julessouren/kicad-library-sa/SA_3dshapes/Knobs/vol control/Assem1.SLDASM

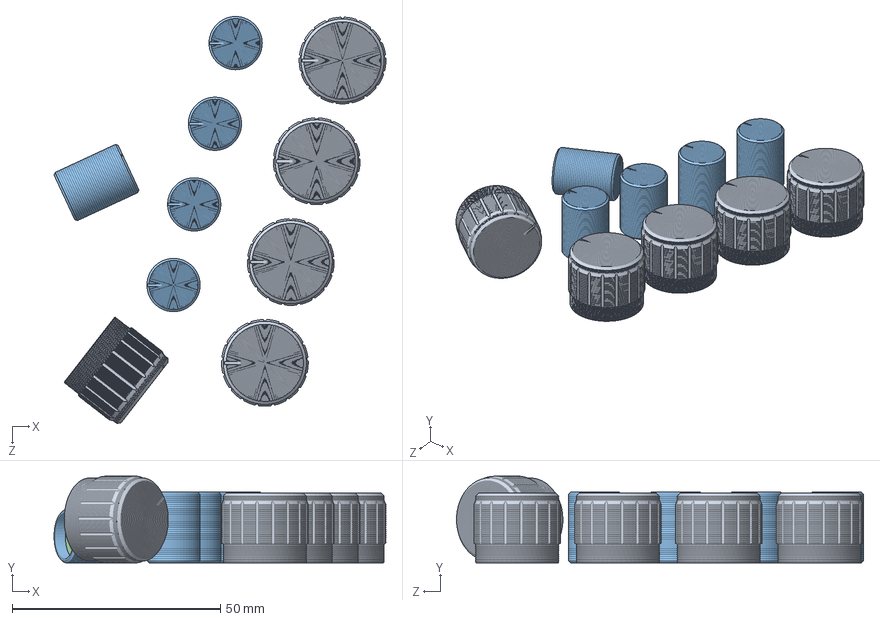
[picture p1: CAD file, 2019-04-16]
SA_3dshapes/Knobs/vol control/Assem1.SLDASM
79.7 x 20.8 x 97.8 mm
宽 20 out x 5
宽 20 inner x 5
12.8 旋钮 x 5
12.8 INNER x 5
