julessouren/kicad-library-sa/SA_3dshapes/Knobs/vol control/宽 20 旋钮.SLDASM

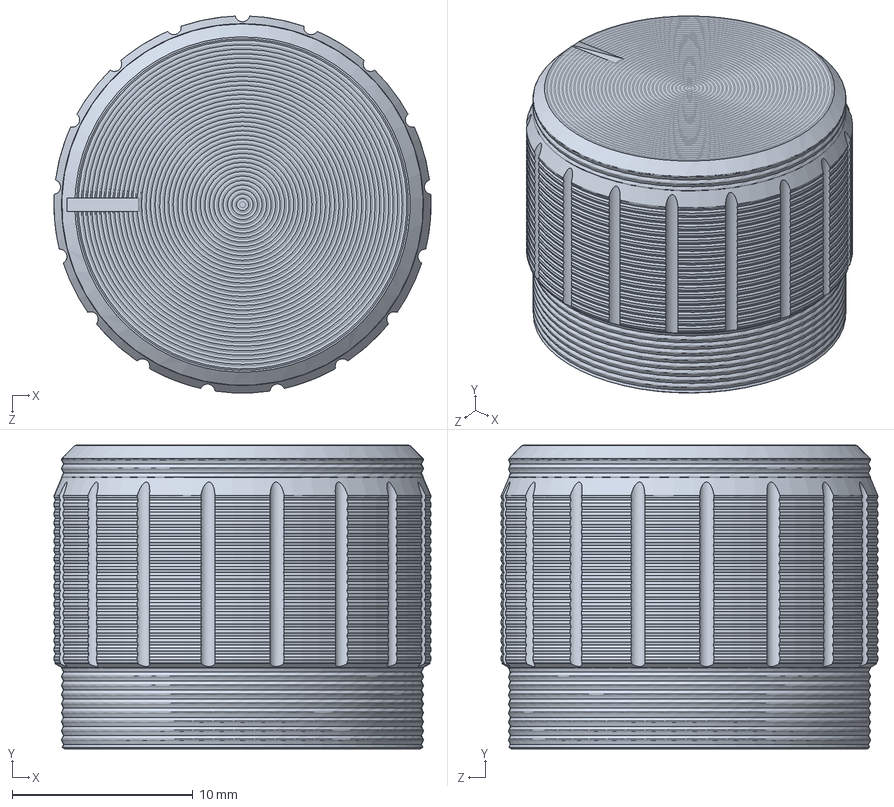
[picture p2: CAD file, 2019-04-16]
SA_3dshapes/Knobs/vol control/宽 20 旋钮.SLDASM
20.8 x 16.8 x 20.8 mm
宽 20 out
宽 20 inner
