julessouren/kicad-library-sa/SA_3dshapes/Packages/InputJack_Cover_Assembly.stp

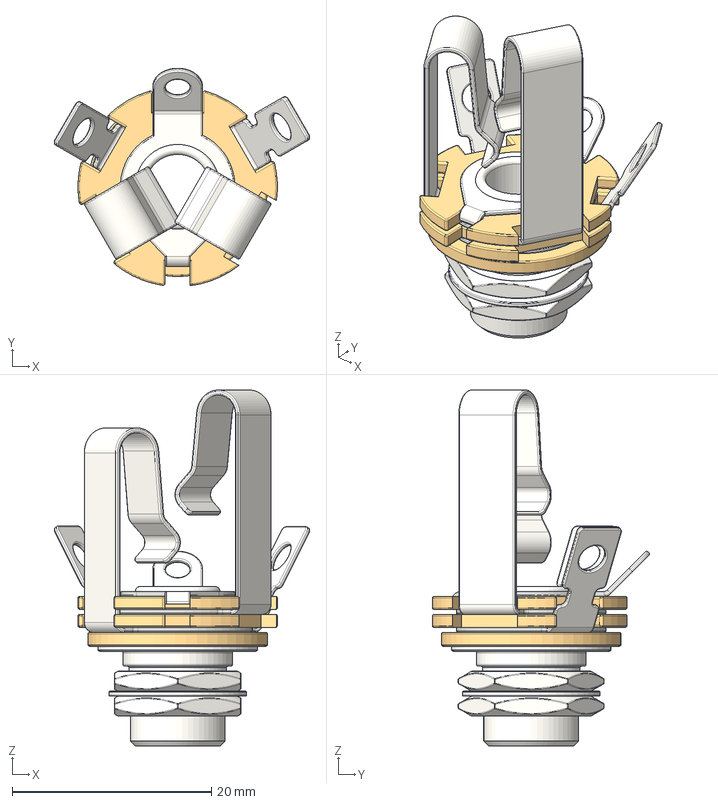
[picture p3: CAD file, 2019-03-04]
SA_3dshapes/Packages/InputJack_Cover_Assembly.stp
25.6 x 21.8 x 35.7 mm
InputJack_shield
InputJack_partition1
InputJack_partition2 x 2
InputJack_nut x 2
InputJack_Washer
InputJack_signal2
InputJack_signal1
