julessouren/kicad-library-sa/SA_3dshapes/Alpha_Taiwan_RD901F-20/Alpha_Taiwan_RD901F-20-15R_Top.step

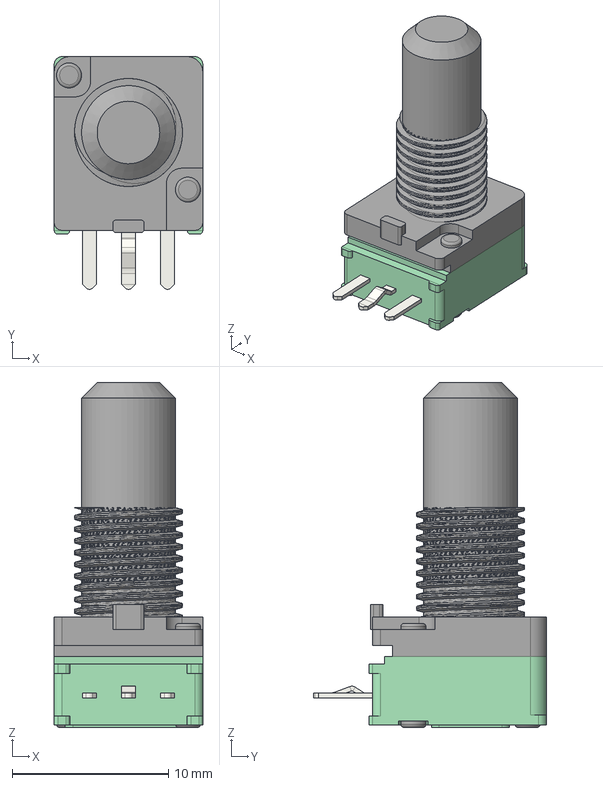
[picture p4: CAD file, 2019-03-11]
SA_3dshapes/Alpha_Taiwan_RD901F-20/Alpha_Taiwan_RD901F-20-15R_Top.step
9.50 x 14.9 x 22.1 mm
