julessouren/kicad-library-sa/SA_3dshapes/Alpha_Taiwan_RD901F-40/Alpha_Taiwan_RD901F-40.step

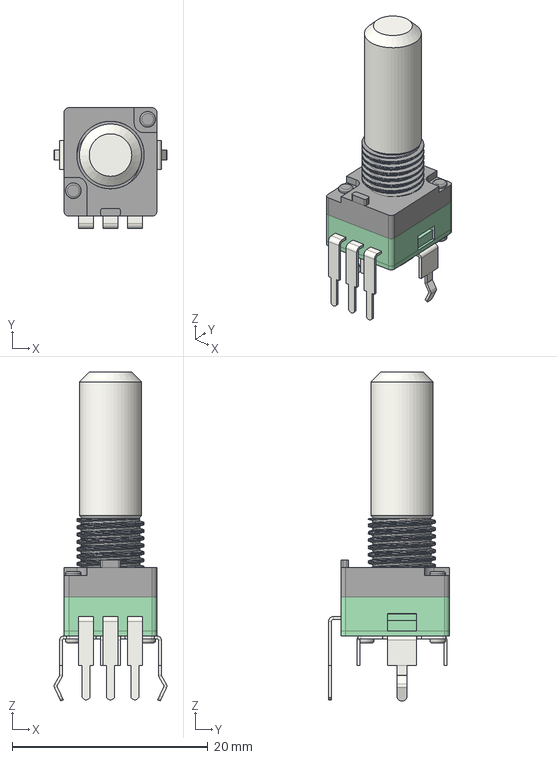
[picture p5: CAD file, 2018-12-31]
SA_3dshapes/Alpha_Taiwan_RD901F-40/Alpha_Taiwan_RD901F-40.step
11.5 x 12.4 x 33.6 mm
