julessouren/kicad-library-sa/SA_3dshapes/Alpha_Taiwan_RD902F-20/Alpha_Taiwain_RD902F-20.step

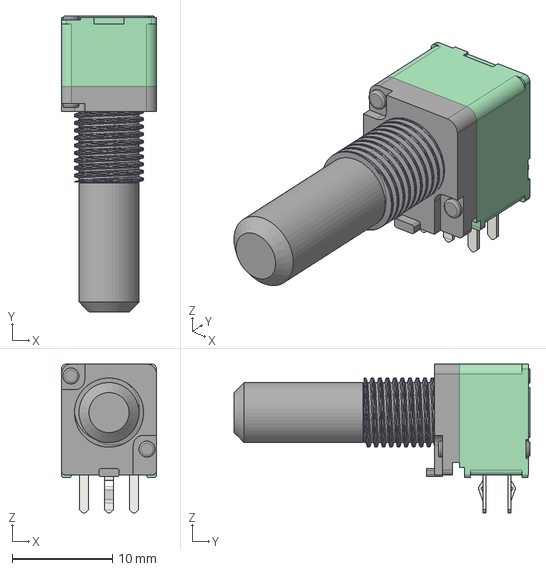
[picture p6: CAD file, 2019-03-04]
SA_3dshapes/Alpha_Taiwan_RD902F-20/Alpha_Taiwain_RD902F-20.step
9.50 x 29.6 x 14.9 mm
