julessouren/kicad-library-sa/SA_3dshapes/Alpha_Taiwan_RD902F-40/Alpha_Taiwan_RD902F-40.step

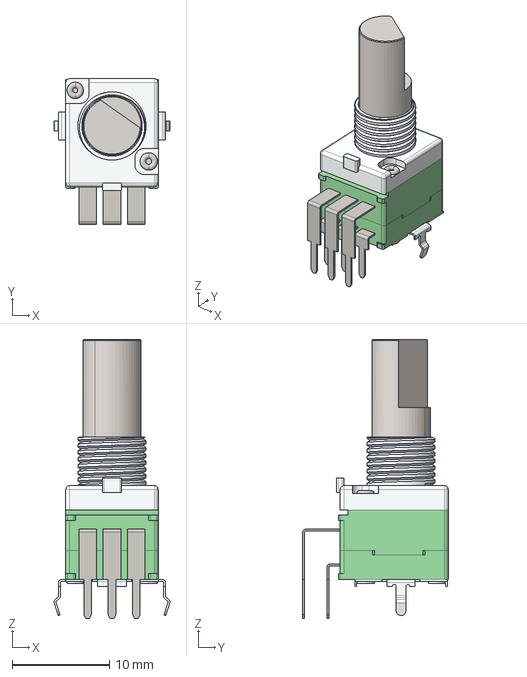
[picture p7: CAD file, 2019-03-04]
SA_3dshapes/Alpha_Taiwan_RD902F-40/Alpha_Taiwan_RD902F-40.step
11.9 x 14.9 x 28.6 mm
