julessouren/kicad-library-sa/SA_3dshapes/Alpha_Taiwan_RV09AF-40/Alpha_Taiwan_RV09AF-40.step

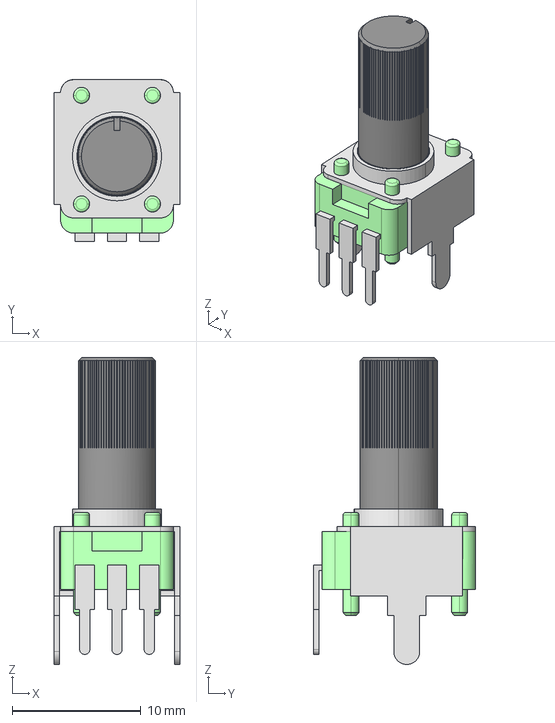
[picture p8: CAD file, 2019-03-04]
SA_3dshapes/Alpha_Taiwan_RV09AF-40/Alpha_Taiwan_RV09AF-40.step
9.75 x 12.6 x 23.8 mm
