julessouren/kicad-library-sa/SA_3dshapes/Alpha_Taiwan_RV16A01F-10/Stereo_Pot_Direct_Export.step

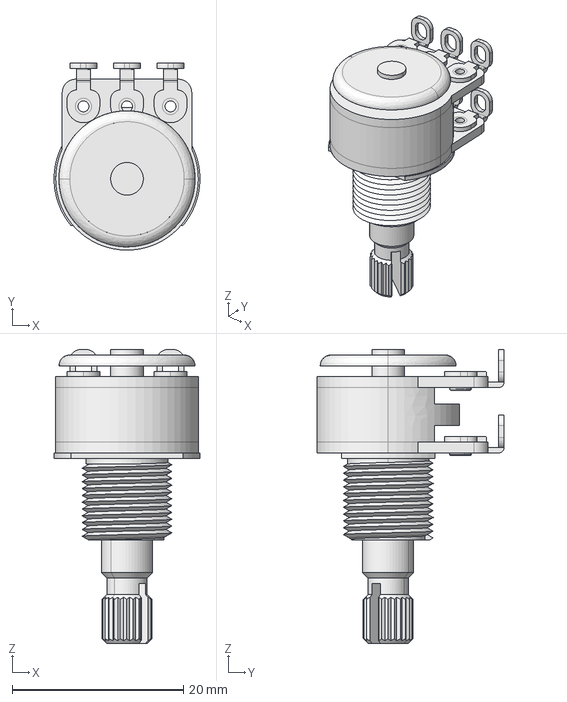
[picture p9: CAD file, 2019-03-04]
SA_3dshapes/Alpha_Taiwan_RV16A01F-10/Stereo_Pot_Direct_Export.step
17.0 x 21.8 x 34.3 mm
