julessouren/kicad-library-sa/SA_3dshapes/Alpha_Taiwan_RV16A01F-20/Alpha_Taiwan_RV16A01F-20-BrownOriginal.step

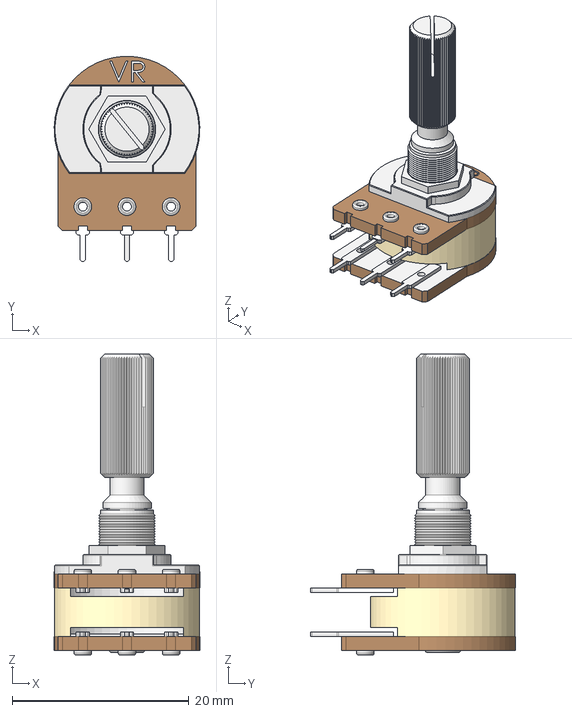
[picture p10: CAD file, 2019-03-04]
SA_3dshapes/Alpha_Taiwan_RV16A01F-20/Alpha_Taiwan_RV16A01F-20-BrownOriginal.step
16.5 x 23.2 x 34.1 mm
