julessouren/kicad-library-sa/SA_3dshapes/Alpha_Taiwan_RV16AF-10/Alpha_Taiwan_RV16AF-10.step

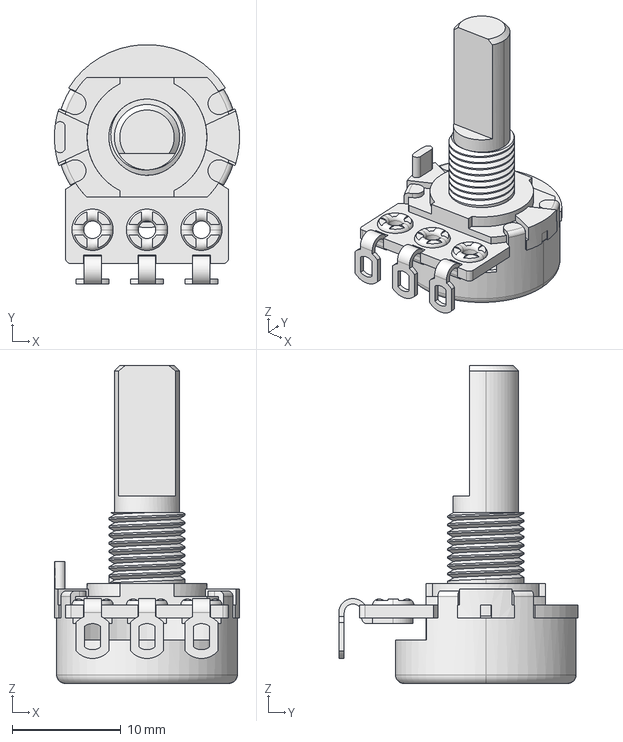
[picture p11: CAD file, 2019-03-04]
SA_3dshapes/Alpha_Taiwan_RV16AF-10/Alpha_Taiwan_RV16AF-10.step
17.0 x 22.0 x 29.2 mm
