julessouren/kicad-library-sa/SA_3dshapes/Alpha_Taiwan_RV16AF-20/Alpha_Taiwan_RV16AF-20_Top.step

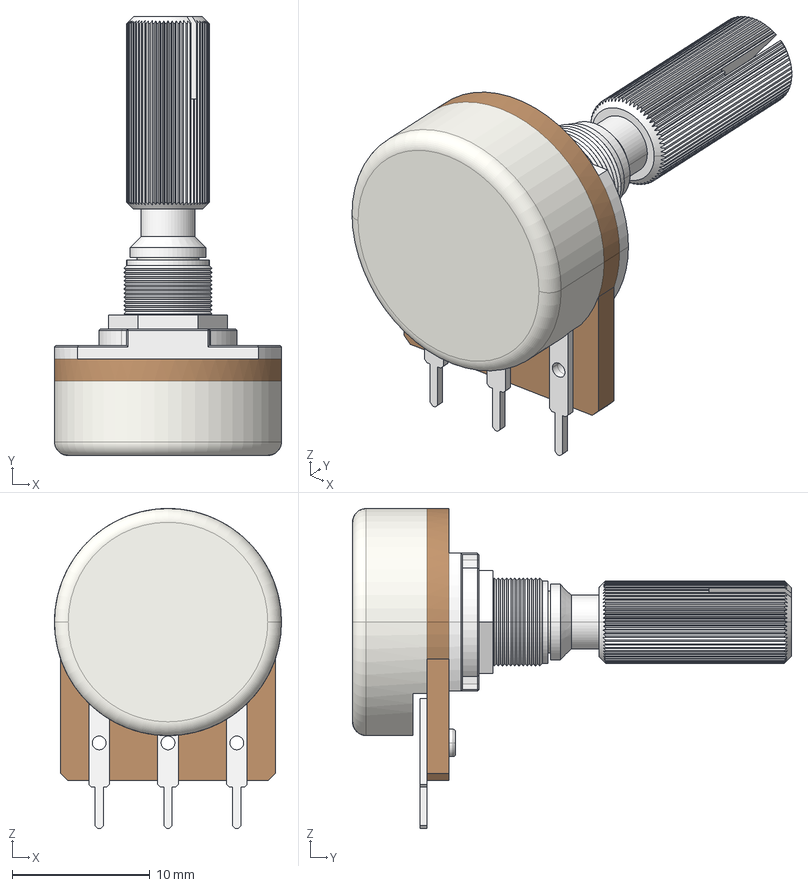
[picture p12: CAD file, 2019-03-11]
SA_3dshapes/Alpha_Taiwan_RV16AF-20/Alpha_Taiwan_RV16AF-20_Top.step
16.5 x 31.9 x 23.2 mm
