julessouren/kicad-library-sa/SA_3dshapes/Alpha_Taiwan_RV24AF-10/Alpha_Taiwan_RV24AF-10.step

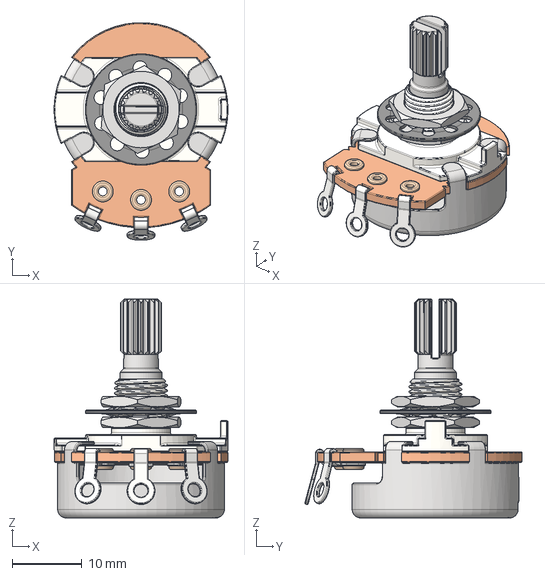
[picture p13: CAD file, 2019-03-04]
SA_3dshapes/Alpha_Taiwan_RV24AF-10/Alpha_Taiwan_RV24AF-10.step
25.0 x 31.3 x 31.5 mm
