julessouren/kicad-library-sa/SA_3dshapes/Alpha_Taiwan_SF17010F-0302-21R-L/Alpha_Taiwan_SF17010F-0302-21R-L.step

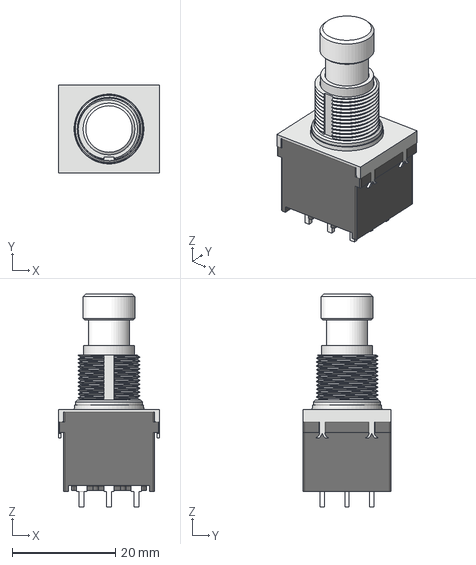
[picture p14: CAD file, 2019-03-04]
SA_3dshapes/Alpha_Taiwan_SF17010F-0302-21R-L/Alpha_Taiwan_SF17010F-0302-21R-L.step
19.6 x 17.0 x 41.2 mm
