julessouren/kicad-library-sa/SA_3dshapes/Amphenol_ACJS-MHOM/Amphenol_ACJS-MHOM.step

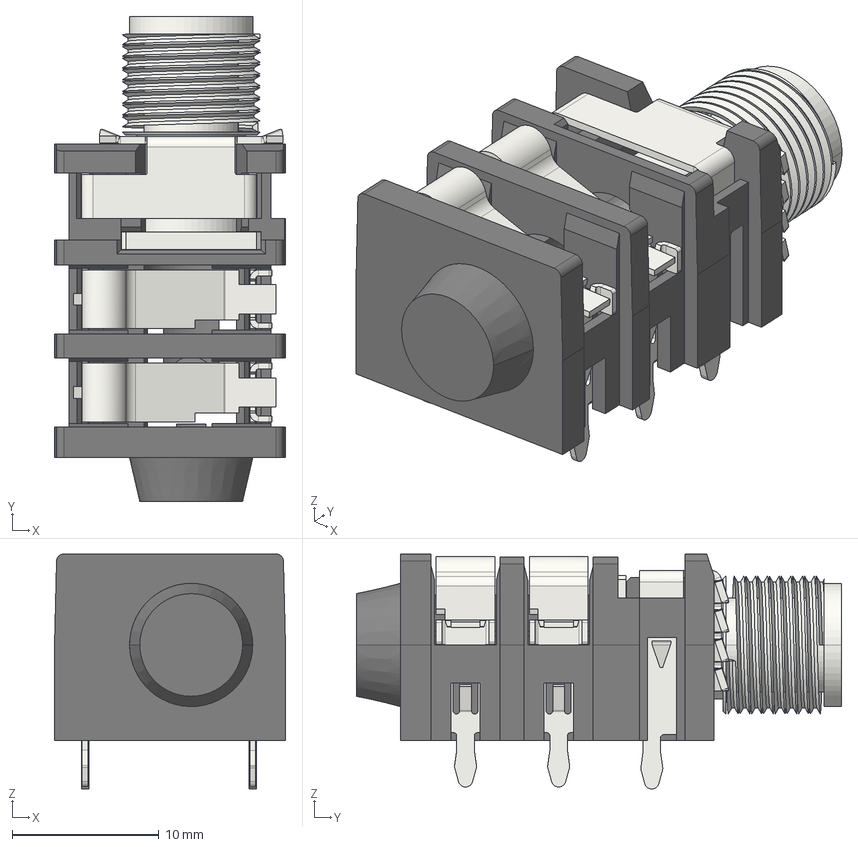
[picture p15: CAD file, 2019-06-19]
SA_3dshapes/Amphenol_ACJS-MHOM/Amphenol_ACJS-MHOM.step
15.8 x 33.1 x 16.0 mm
