julessouren/kicad-library-sa/SA_3dshapes/Atmel_ATtiny13A-PU/Atmel_ATtiny13A-PU_Socketed.step

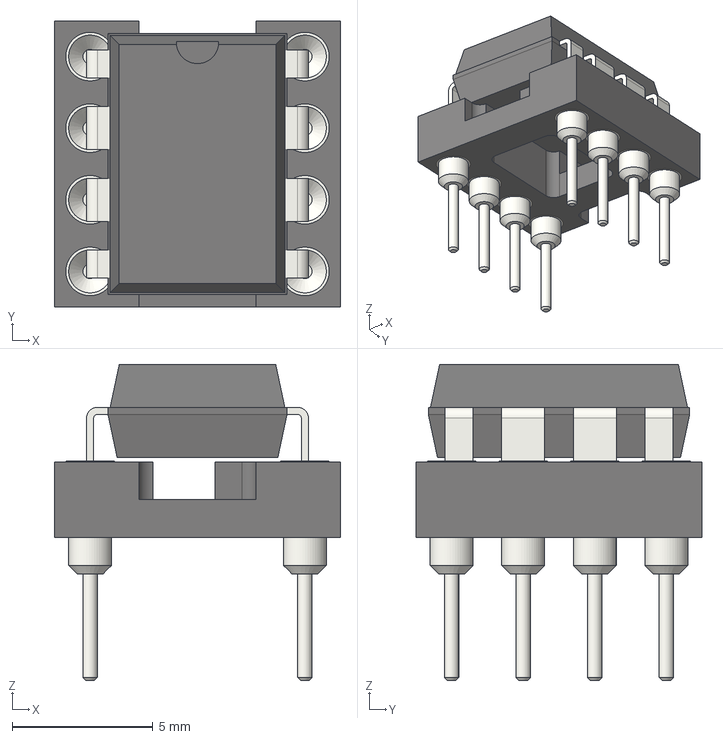
[picture p16: CAD file, 2018-12-28]
SA_3dshapes/Atmel_ATtiny13A-PU/Atmel_ATtiny13A-PU_Socketed.step
10.2 x 10.2 x 11.2 mm
