julessouren/kicad-library-sa/SA_3dshapes/Belton_BTDR-2H/Belton_BTDR-2H.step

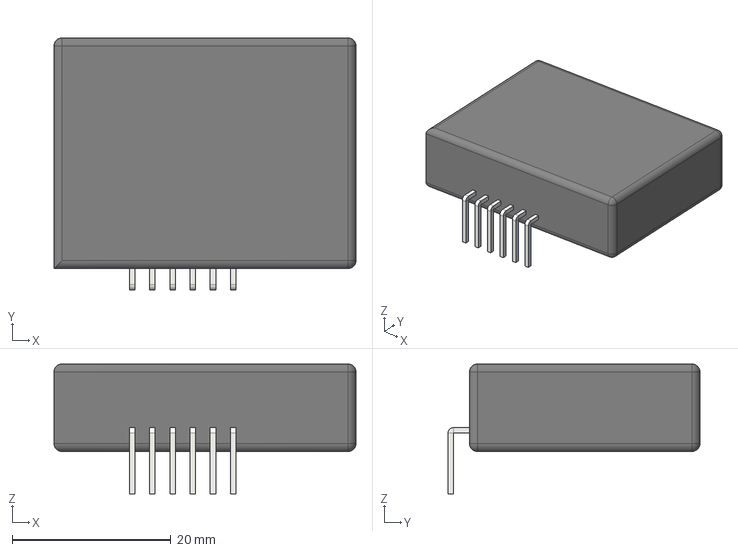
[picture p17: CAD file, 2019-06-19]
SA_3dshapes/Belton_BTDR-2H/Belton_BTDR-2H.step
38.0 x 31.7 x 16.4 mm
