julessouren/kicad-library-sa/SA_3dshapes/Bourns_3296W-1-104/Bourns_3296W-1-104.step

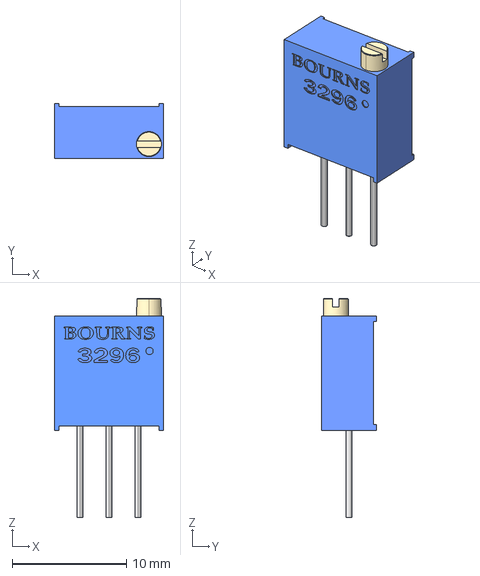
[picture p18: CAD file, 2018-12-31]
SA_3dshapes/Bourns_3296W-1-104/Bourns_3296W-1-104.step
9.53 x 4.83 x 19.2 mm
