julessouren/kicad-library-sa/SA_3dshapes/Bourns_3314G-1-104E/Bourns_3314G-1-104E.step

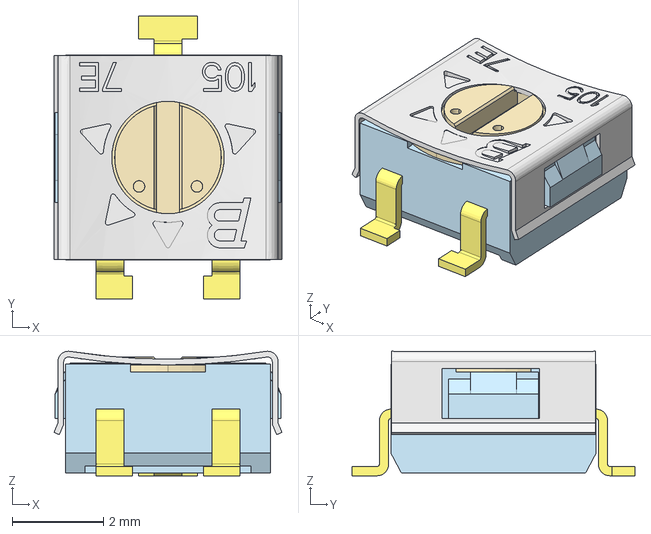
[picture p19: CAD file, 2018-12-31]
SA_3dshapes/Bourns_3314G-1-104E/Bourns_3314G-1-104E.step
5.00 x 6.20 x 2.73 mm
