julessouren/kicad-library-sa/SA_3dshapes/Bourns_3362P-1-104/Bourns_3362P-1-104.step

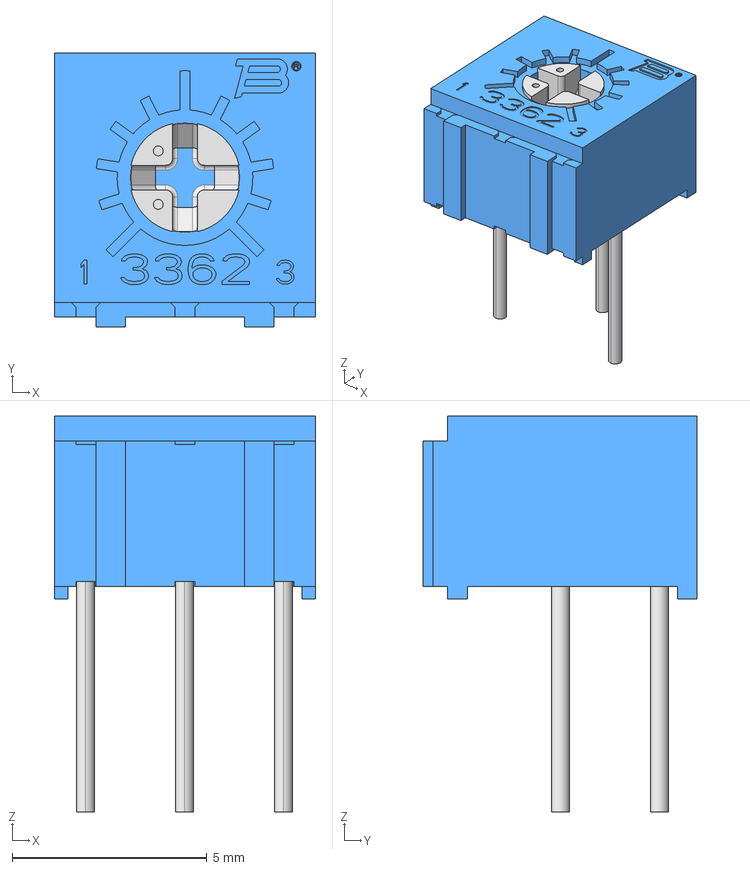
[picture p20: CAD file, 2018-12-31]
SA_3dshapes/Bourns_3362P-1-104/Bourns_3362P-1-104.step
6.71 x 7.04 x 10.2 mm
