julessouren/kicad-library-sa/SA_3dshapes/Bourns_TC33X-2-104E/Bourns_TC33X-2-104E.step

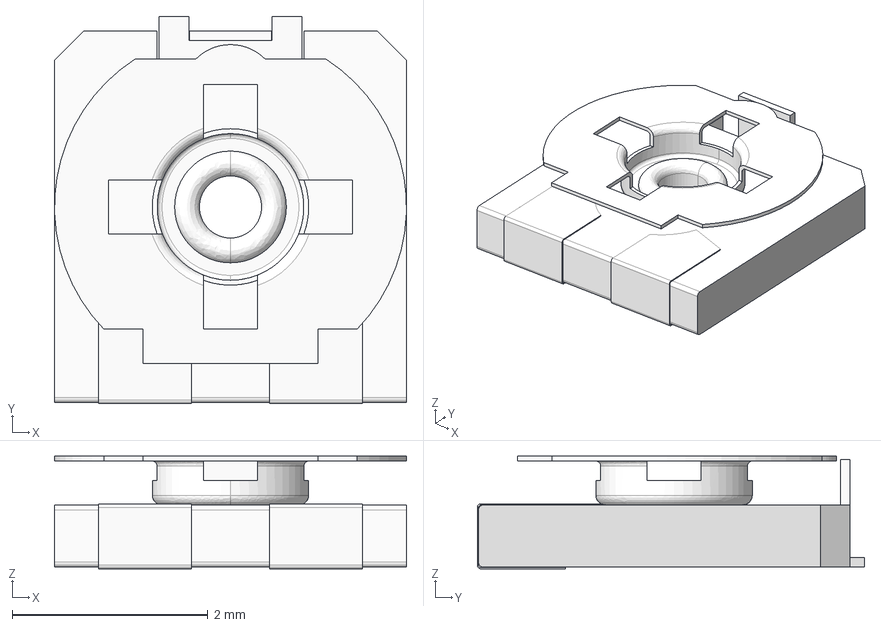
[picture p21: CAD file, 2018-12-31]
SA_3dshapes/Bourns_TC33X-2-104E/Bourns_TC33X-2-104E.step
3.60 x 3.96 x 1.15 mm
