julessouren/kicad-library-sa/SA_3dshapes/C&K_7101SYZBE/C&K_GT12MCBE.step

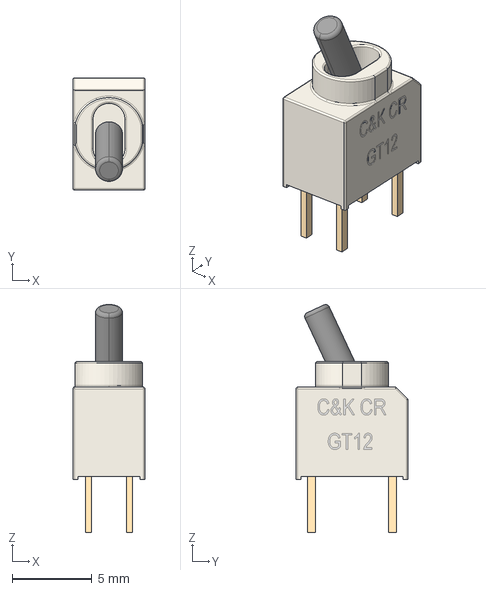
[picture p22: CAD file, 2019-03-04]
SA_3dshapes/C&K_7101SYZBE/C&K_GT12MCBE.step
4.50 x 7.01 x 14.3 mm
