julessouren/kicad-library-sa/SA_3dshapes/Hammond_1590A/1590A_NoLid.step

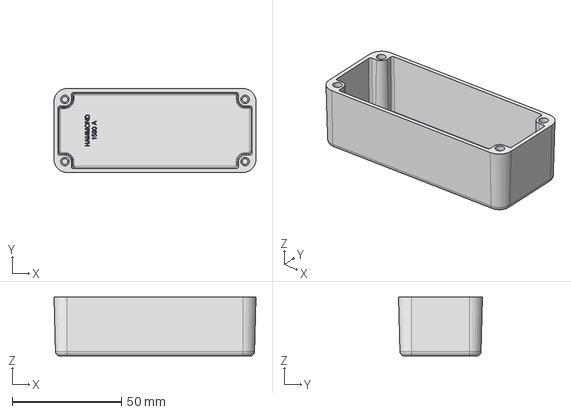
[picture p23: CAD file, 2019-02-08]
SA_3dshapes/Hammond_1590A/1590A_NoLid.step
92.6 x 38.5 x 27.0 mm
