julessouren/kicad-library-sa/SA_3dshapes/Hammond_1590B/1590A_NoLid.step

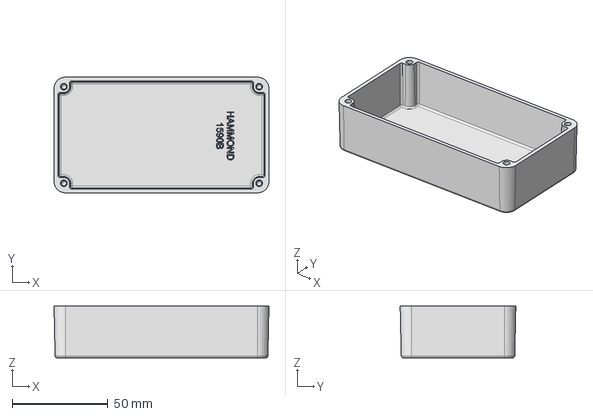
[picture p24: CAD file, 2019-02-08]
SA_3dshapes/Hammond_1590B/1590A_NoLid.step
112.4 x 60.5 x 27.0 mm
