julessouren/kicad-library-sa/SA_3dshapes/Hammond_1590BB/1590BB_NoLid.step

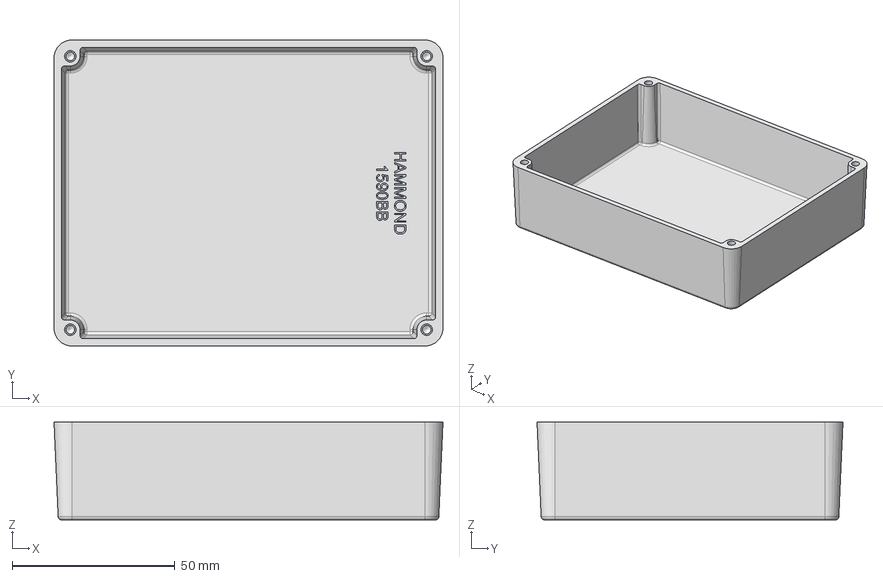
[picture p25: CAD file, 2019-02-08]
SA_3dshapes/Hammond_1590BB/1590BB_NoLid.step
119.5 x 94.0 x 30.0 mm
