julessouren/kicad-library-sa/SA_3dshapes/Hardware/Hex Spacers/Hex Spacer FF M3 L16mm.stp

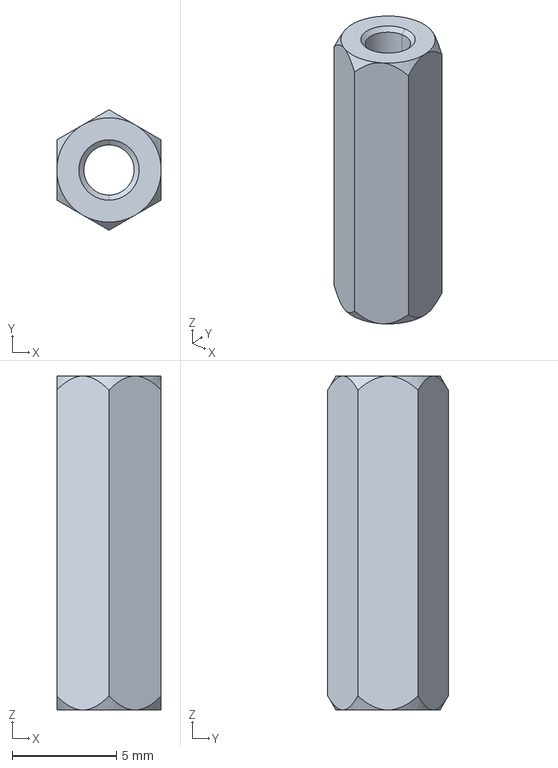
[picture p26: CAD file, 2019-04-16]
SA_3dshapes/Hardware/Hex Spacers/Hex Spacer FF M3 L16mm.stp
5.00 x 5.77 x 16.0 mm
