julessouren/kicad-library-sa/SA_3dshapes/Kemet_EA2-5NJ/Kemet_EA2-5NJ_Socketed.step

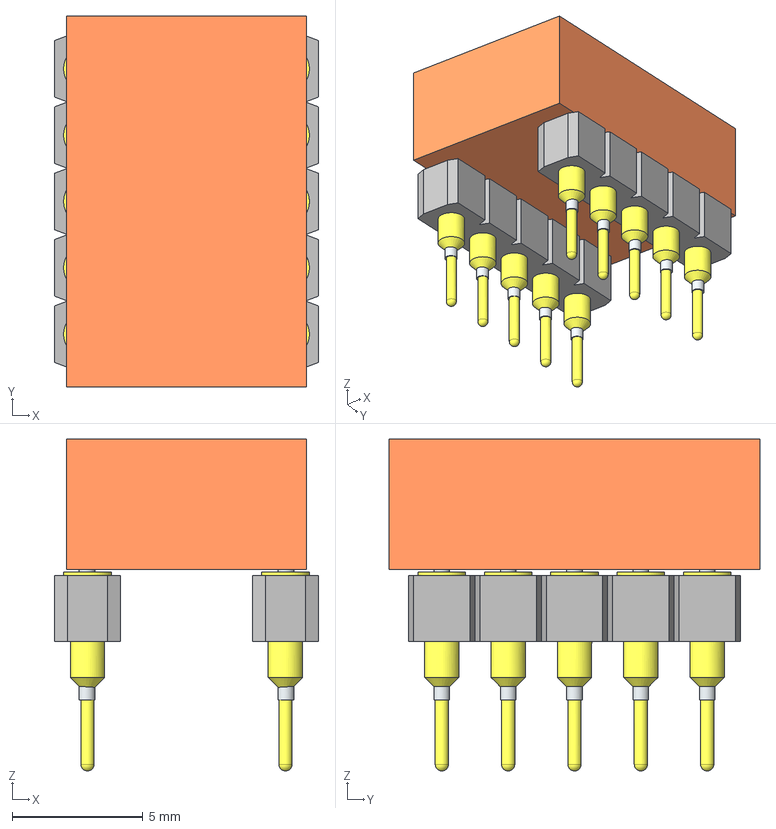
[picture p27: CAD file, 2019-02-25]
SA_3dshapes/Kemet_EA2-5NJ/Kemet_EA2-5NJ_Socketed.step
10.1 x 14.2 x 12.7 mm
