julessouren/kicad-library-sa/SA_3dshapes/Knobs/User Library-ALCO-KB500B-1-8S-KNOB.STEP

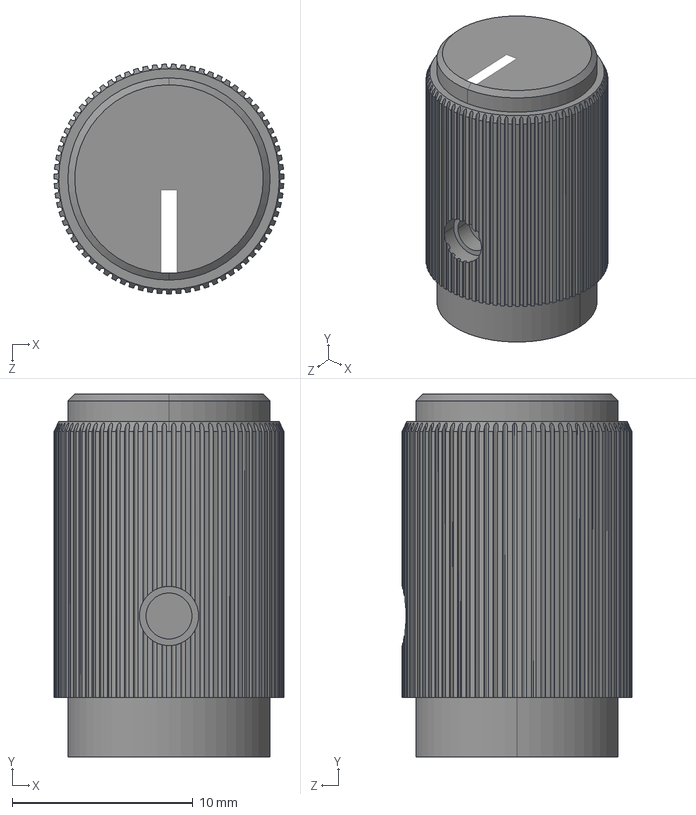
[picture p28: CAD file, 2019-04-16]
SA_3dshapes/Knobs/User Library-ALCO-KB500B-1-8S-KNOB.STEP
12.7 x 20.1 x 12.7 mm
