julessouren/kicad-library-sa/SA_3dshapes/Knobs/vol control/宽 20 out.SLDPRT

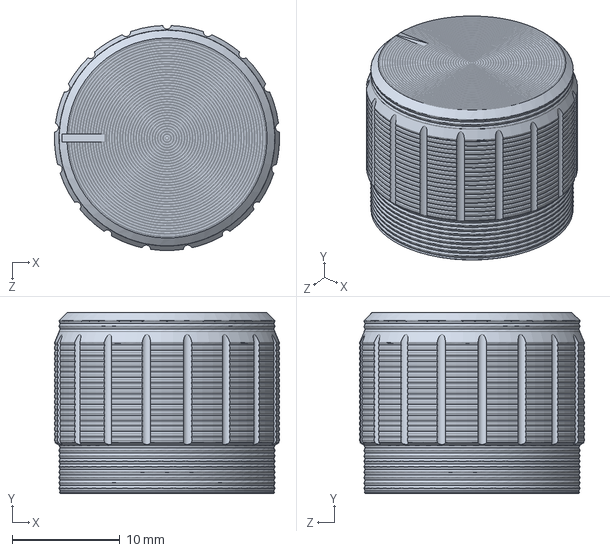
[picture p29: CAD file, 2019-04-16]
SA_3dshapes/Knobs/vol control/宽 20 out.SLDPRT
20.8 x 16.8 x 20.8 mm
