julessouren/kicad-library-sa/SA_3dshapes/Lumberg_1614_09/Lumberg_1614_09_Bottom_Combined.step

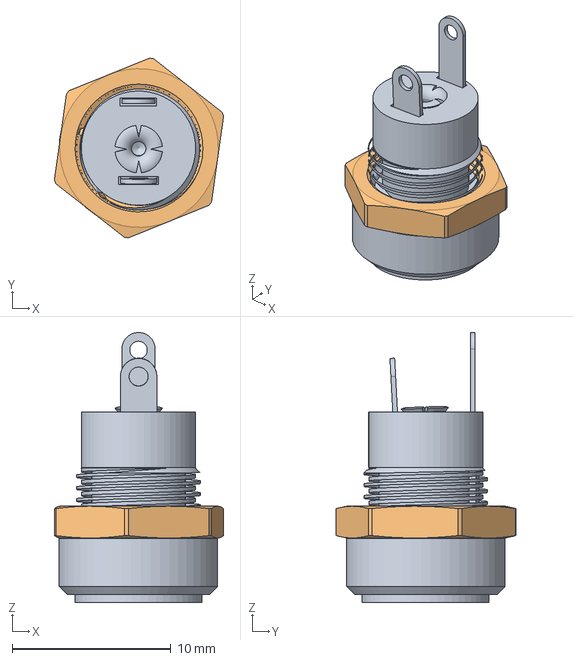
[picture p30: CAD file, 2019-02-05]
SA_3dshapes/Lumberg_1614_09/Lumberg_1614_09_Bottom_Combined.step
10.7 x 11.3 x 17.0 mm
