julessouren/kicad-library-sa/SA_3dshapes/Lumberg_KLBM_3/Lumberg_KLBM_3.step

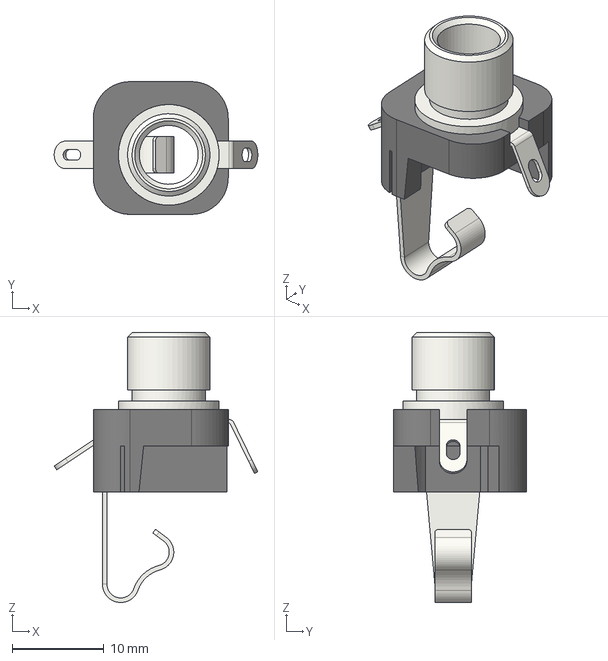
[picture p31: CAD file, 2019-06-19]
SA_3dshapes/Lumberg_KLBM_3/Lumberg_KLBM_3.step
22.2 x 14.5 x 29.5 mm
