julessouren/kicad-library-sa/SA_3dshapes/Lumberg_NEB_21_R/LUMBERG-NEB-21-R.step

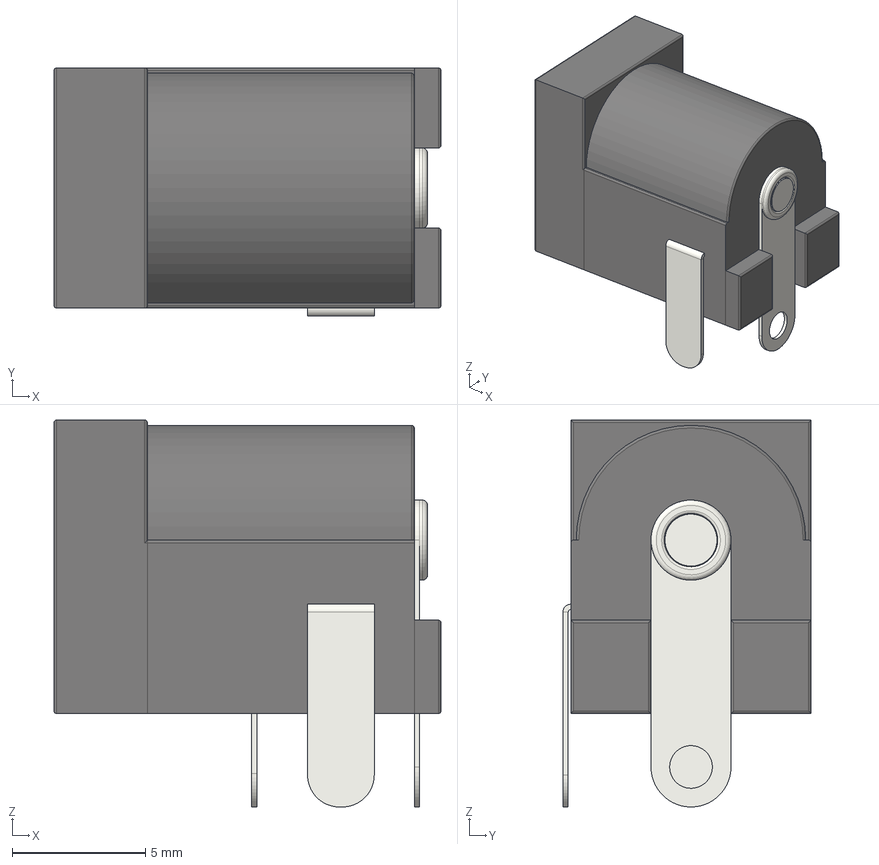
[picture p32: CAD file, 2019-01-04]
SA_3dshapes/Lumberg_NEB_21_R/LUMBERG-NEB-21-R.step
14.5 x 9.30 x 14.5 mm
