julessouren/kicad-library-sa/SA_3dshapes/Lumberg_NEB_J_21_C/Lumberg_NEB_J_21_C.step

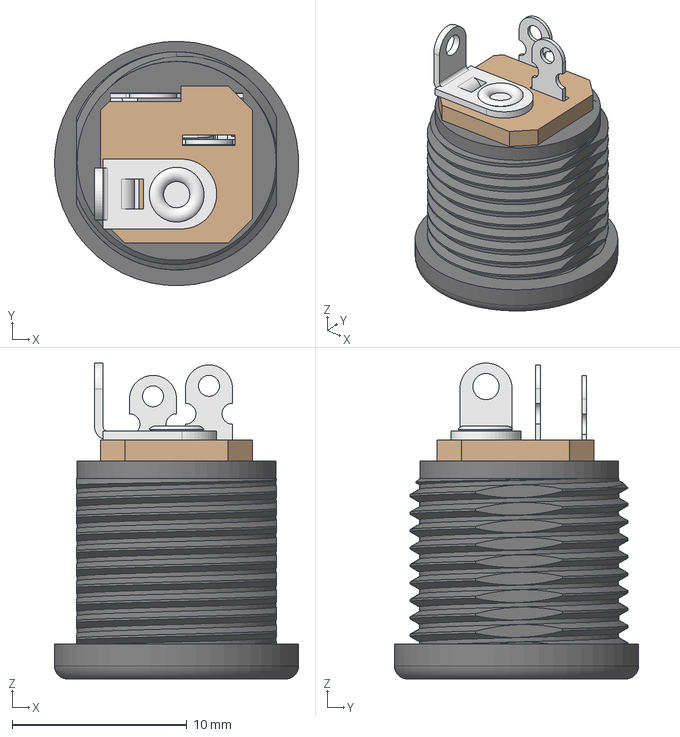
[picture p33: CAD file, 2019-06-19]
SA_3dshapes/Lumberg_NEB_J_21_C/Lumberg_NEB_J_21_C.step
14.0 x 14.0 x 18.1 mm
