julessouren/kicad-library-sa/SA_3dshapes/Neutrik_NMJ6HCD2/Neutrik_NMJ6HCD2_OnlyNose.step

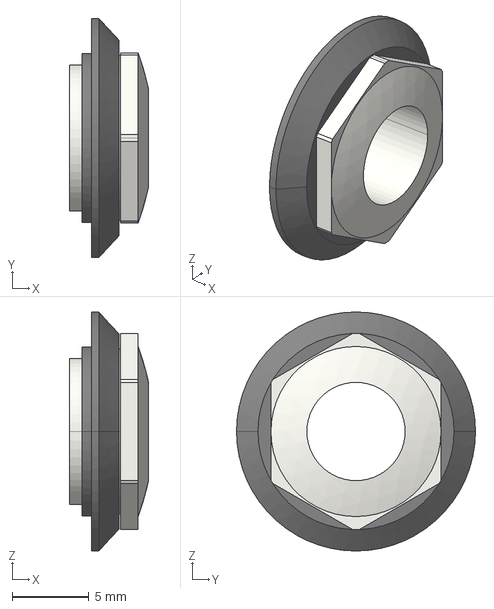
[picture p34: CAD file, 2019-06-19]
SA_3dshapes/Neutrik_NMJ6HCD2/Neutrik_NMJ6HCD2_OnlyNose.step
5.17 x 15.6 x 15.6 mm
