julessouren/kicad-library-sa/SA_3dshapes/Neutrik_NRJ6HM-1/nrj6hm-1-1.stp

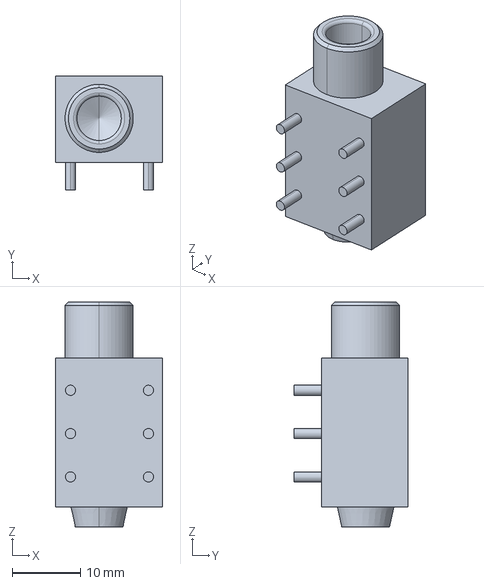
[picture p35: CAD file, 2019-01-04]
SA_3dshapes/Neutrik_NRJ6HM-1/nrj6hm-1-1.stp
15.8 x 16.7 x 33.0 mm
