julessouren/kicad-library-sa/SA_3dshapes/Nichicon_UWT1E101MCL1GS_100uF_25V_6.3x7.7mm/Nichicon_UWT1E101MCL1GS_100uF_25V_6.3x7.7mm.step

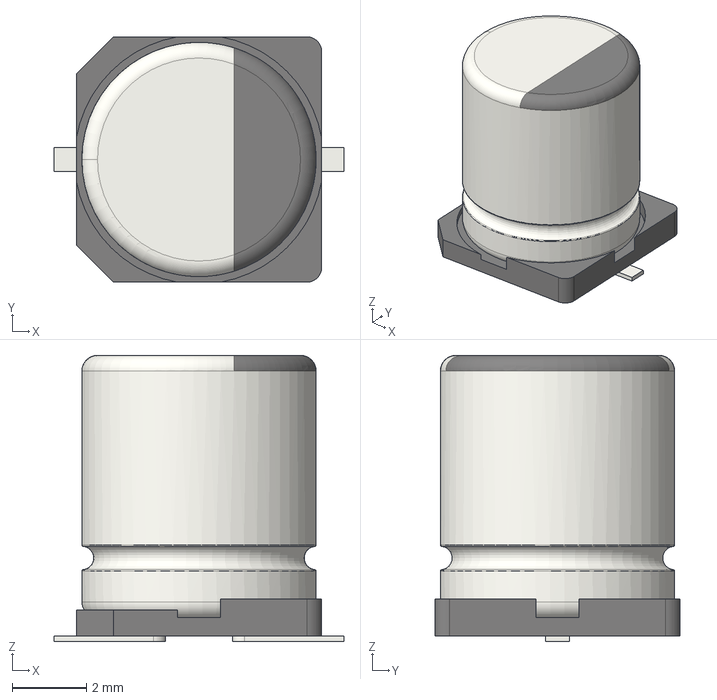
[picture p36: CAD file, 2018-12-28]
SA_3dshapes/Nichicon_UWT1E101MCL1GS_100uF_25V_6.3x7.7mm/Nichicon_UWT1E101MCL1GS_100uF_25V_6.3x7.7mm.step
7.80 x 6.60 x 7.70 mm
