julessouren/kicad-library-sa/SA_3dshapes/Nichicon_UWT1E221MNL1GS_220uF_25V_8.0x10.0mm/Nichicon_UWT1E221MNL1GS_220uF_25V_8.0x10.0mm.step

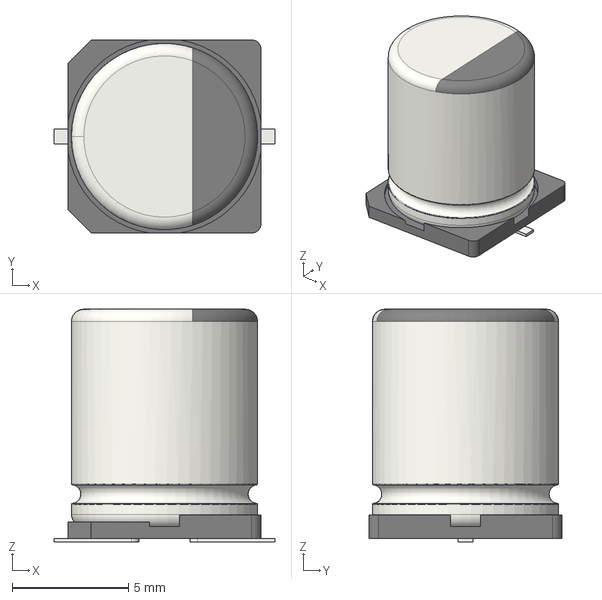
[picture p37: CAD file, 2018-12-28]
SA_3dshapes/Nichicon_UWT1E221MNL1GS_220uF_25V_8.0x10.0mm/Nichicon_UWT1E221MNL1GS_220uF_25V_8.0x10.0mm.step
9.50 x 8.30 x 10.0 mm
