julessouren/kicad-library-sa/SA_3dshapes/Nichicon_UWT1E471MNL1GS_470uF_25V_10.0x10.0mm/Nichicon_UWT1E471MNL1GS_470uF_25V_10.0x10.0mm.step

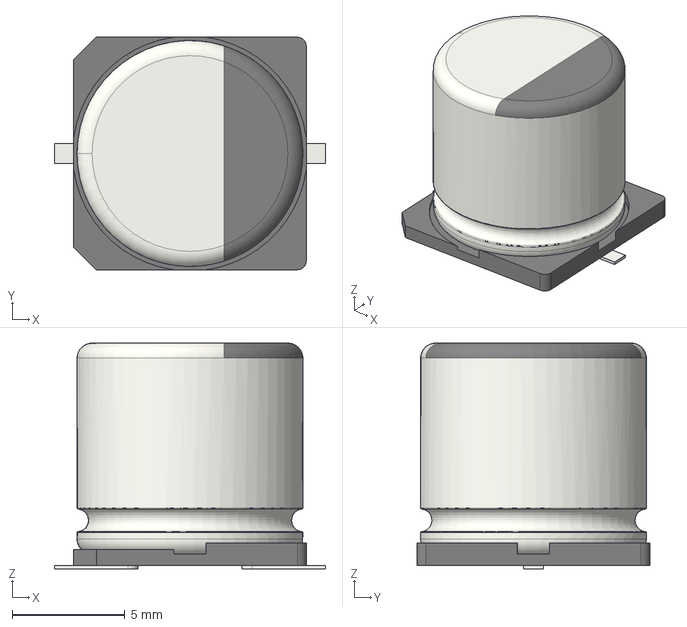
[picture p38: CAD file, 2018-12-28]
SA_3dshapes/Nichicon_UWT1E471MNL1GS_470uF_25V_10.0x10.0mm/Nichicon_UWT1E471MNL1GS_470uF_25V_10.0x10.0mm.step
12.0 x 10.3 x 10.0 mm
