julessouren/kicad-library-sa/SA_3dshapes/Nichicon_UWT1H010MCL1GB_1.0uF_50V_4.0x5.4mm/Nichicon_UWT1H010MCL1GB_1.0uF_50V_4.0x5.4mm.step

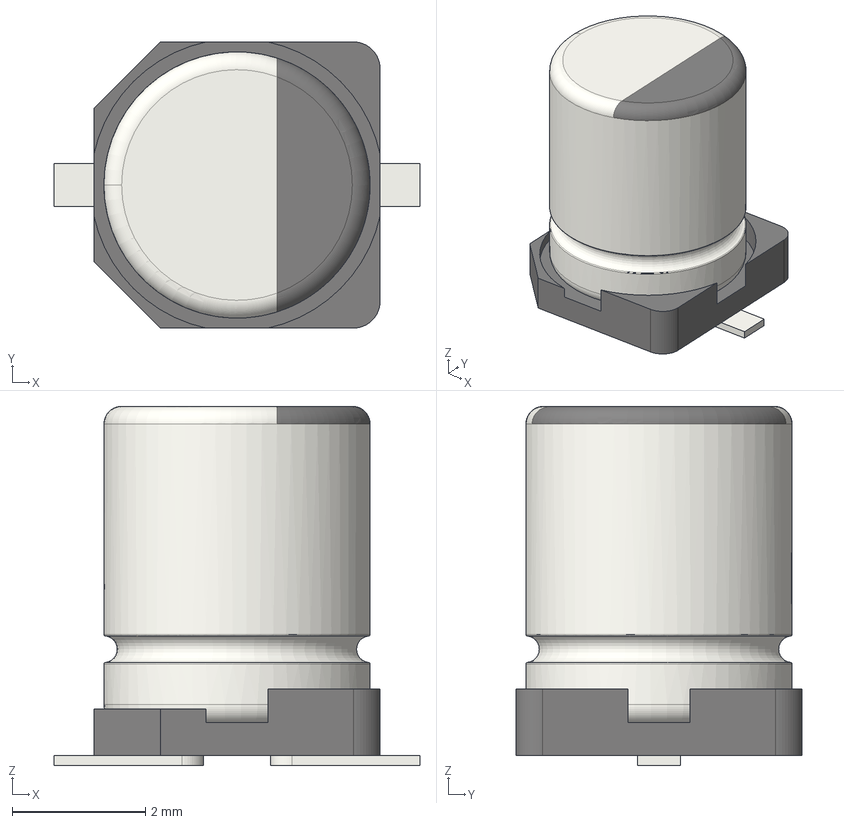
[picture p39: CAD file, 2018-12-28]
SA_3dshapes/Nichicon_UWT1H010MCL1GB_1.0uF_50V_4.0x5.4mm/Nichicon_UWT1H010MCL1GB_1.0uF_50V_4.0x5.4mm.step
5.50 x 4.30 x 5.40 mm
