julessouren/kicad-library-sa/SA_3dshapes/Nichicon_UWT1H4R7MCL1GB_4.7uF_50V_5.0x5.4mm/Nichicon_UWT1H4R7MCL1GB_4.7uF_50V_5.0x5.4mm.step

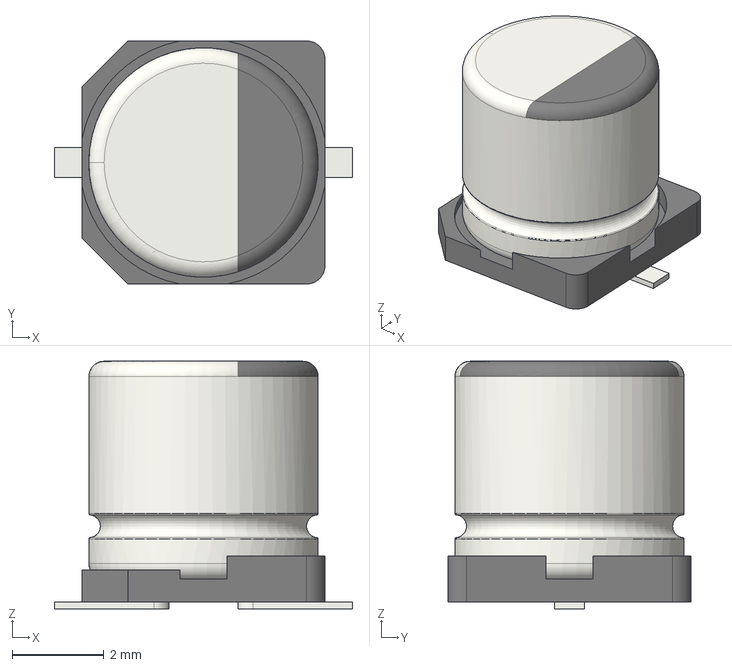
[picture p40: CAD file, 2018-12-28]
SA_3dshapes/Nichicon_UWT1H4R7MCL1GB_4.7uF_50V_5.0x5.4mm/Nichicon_UWT1H4R7MCL1GB_4.7uF_50V_5.0x5.4mm.step
6.50 x 5.30 x 5.40 mm
