julessouren/kicad-library-sa/SA_3dshapes/Nichicon_UWT1V220MCL1GB_22uF_35V_6.3x5.4mm/Nichicon_UWT1V220MCL1GB_22uF_35V_6.3x5.4mm.step

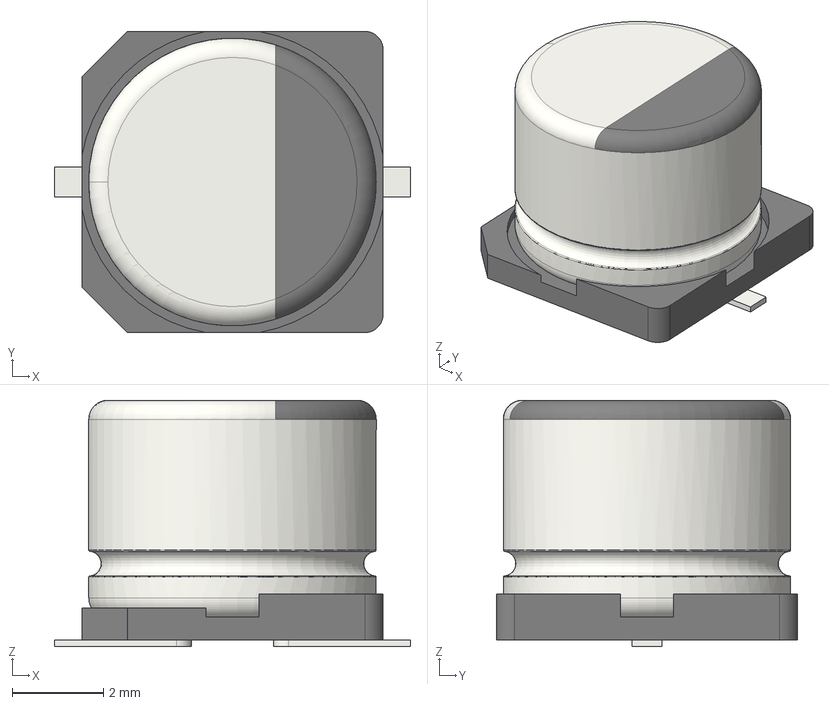
[picture p41: CAD file, 2018-12-28]
SA_3dshapes/Nichicon_UWT1V220MCL1GB_22uF_35V_6.3x5.4mm/Nichicon_UWT1V220MCL1GB_22uF_35V_6.3x5.4mm.step
7.80 x 6.60 x 5.40 mm
