julessouren/kicad-library-sa/SA_3dshapes/Nichicon_UWT1V470MCL1GS_47uF_35V_6.3x5.8mm/Nichicon_UWT1V470MCL1GS_47uF_35V_6.3x5.8mm.step

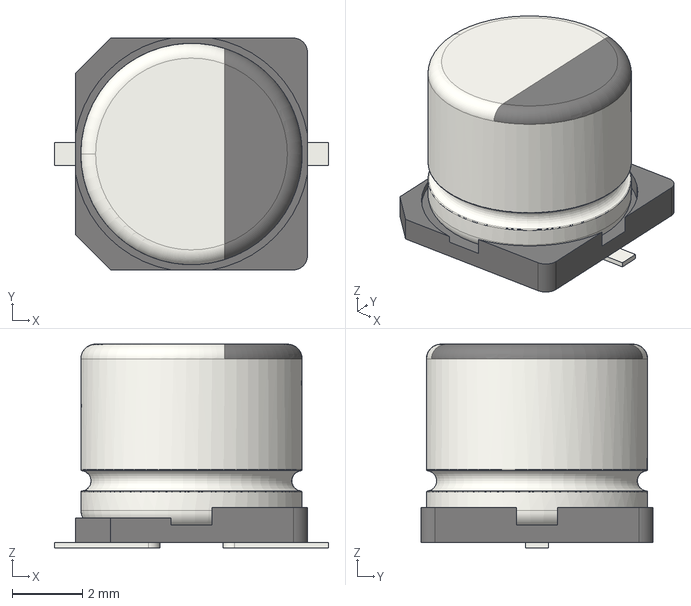
[picture p42: CAD file, 2018-12-28]
SA_3dshapes/Nichicon_UWT1V470MCL1GS_47uF_35V_6.3x5.8mm/Nichicon_UWT1V470MCL1GS_47uF_35V_6.3x5.8mm.step
7.80 x 6.60 x 5.80 mm
