julessouren/kicad-library-sa/SA_3dshapes/ON_Semi_1N4148WS_SOD-323F-2/ON_Semi_1N4148WS_SOD-323F-2.step

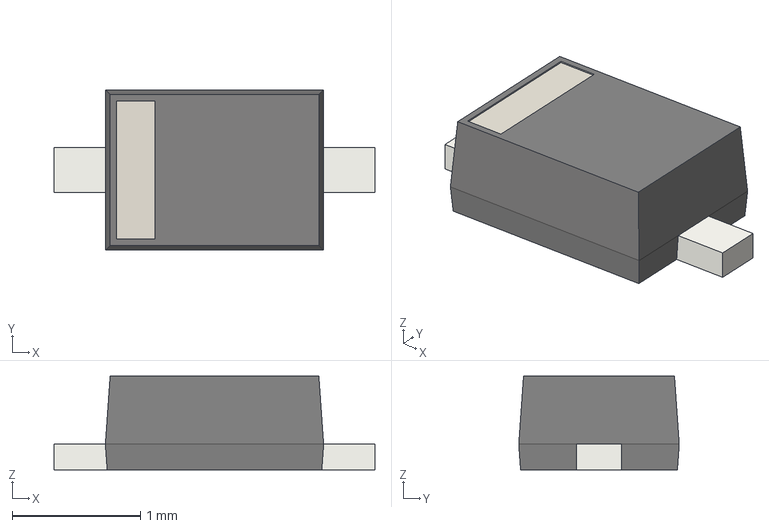
[picture p43: CAD file, 2018-12-27]
SA_3dshapes/ON_Semi_1N4148WS_SOD-323F-2/ON_Semi_1N4148WS_SOD-323F-2.step
2.50 x 1.25 x 0.73 mm
