julessouren/kicad-library-sa/SA_3dshapes/ON_Semi_1SMA5918BT3G_SMA_DO-214AC/ON_Semi_1SMA5918BT3G_SMA_DO-214AC.step

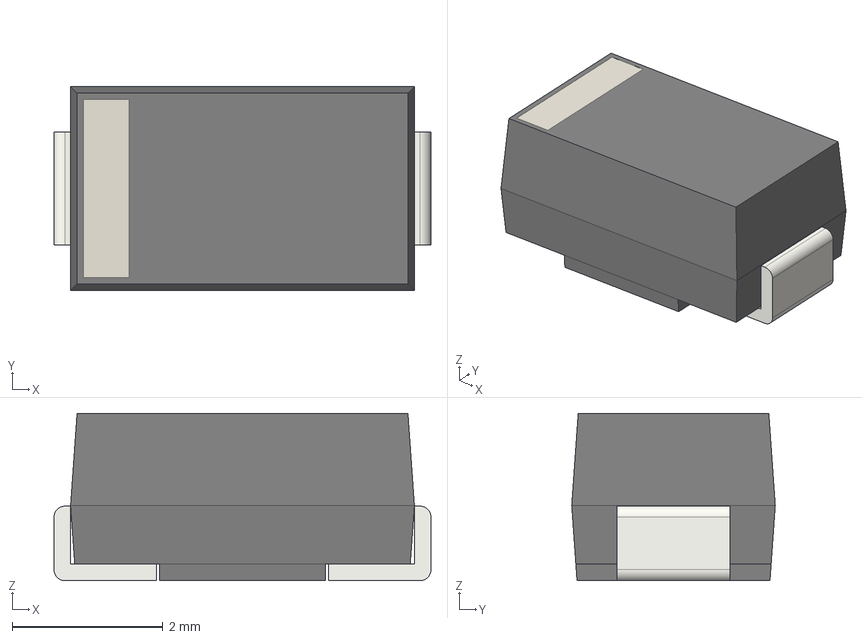
[picture p44: CAD file, 2018-12-27]
SA_3dshapes/ON_Semi_1SMA5918BT3G_SMA_DO-214AC/ON_Semi_1SMA5918BT3G_SMA_DO-214AC.step
5.00 x 2.70 x 2.22 mm
