julessouren/kicad-library-sa/SA_3dshapes/ON_Semi_2N3904TAR-TO-92-3-P2.54/ON_Semi_2N3904TAR-TO-92-3-P2.54_Marking.step

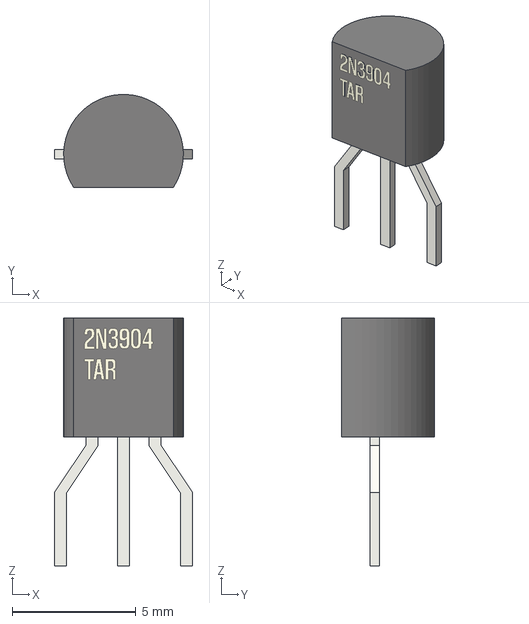
[picture p45: CAD file, 2019-07-16]
SA_3dshapes/ON_Semi_2N3904TAR-TO-92-3-P2.54/ON_Semi_2N3904TAR-TO-92-3-P2.54_Marking.step
5.58 x 3.75 x 10.0 mm
