julessouren/kicad-library-sa/SA_3dshapes/ON_Semi_2N5088TAR-TO-92-3-P1.28/ON_Semi_2N5088TAR-TO-92-3-P1.28.step

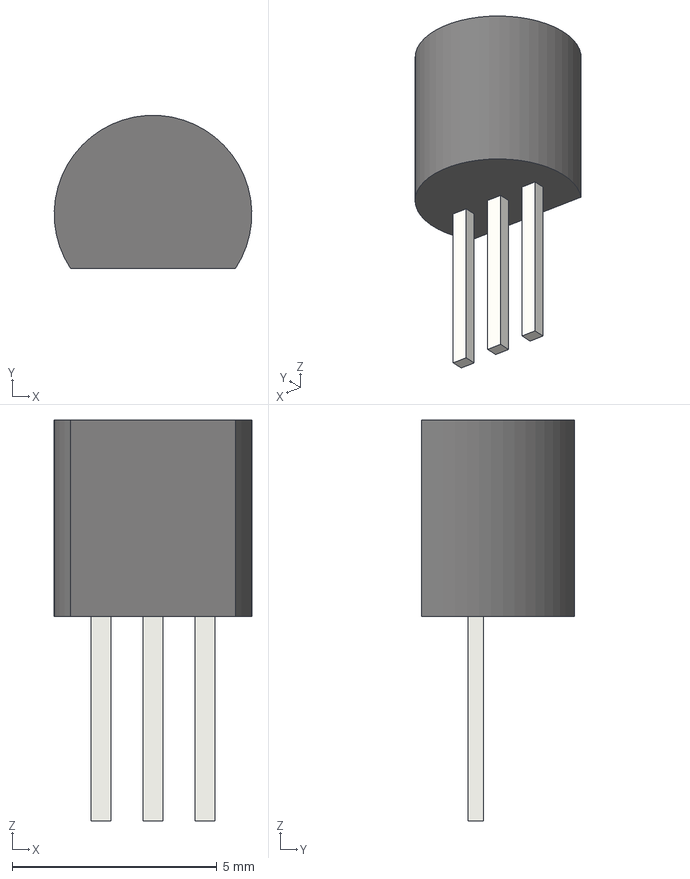
[picture p46: CAD file, 2018-12-31]
SA_3dshapes/ON_Semi_2N5088TAR-TO-92-3-P1.28/ON_Semi_2N5088TAR-TO-92-3-P1.28.step
4.83 x 3.74 x 9.80 mm
