julessouren/kicad-library-sa/SA_3dshapes/ON_Semi_2N7000TA-TO-92-3-P2.54/ON_Semi_2N7000TA-TO-92-3-P2.54.step

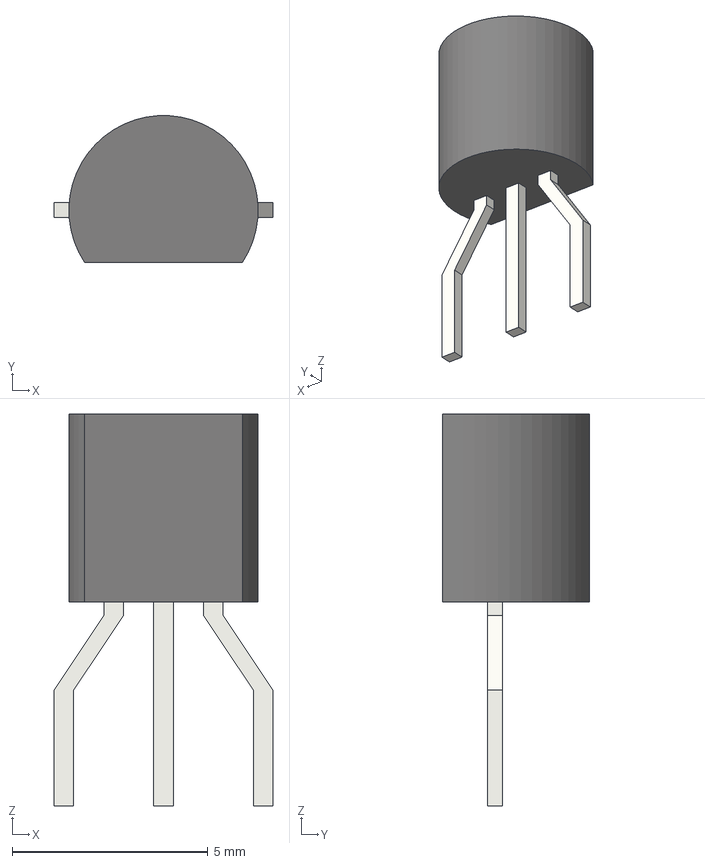
[picture p47: CAD file, 2018-12-28]
SA_3dshapes/ON_Semi_2N7000TA-TO-92-3-P2.54/ON_Semi_2N7000TA-TO-92-3-P2.54.step
5.58 x 3.74 x 10.0 mm
