julessouren/kicad-library-sa/SA_3dshapes/ON_Semi_H11F1M/ON_Semi_H11F1M_Socketed.step

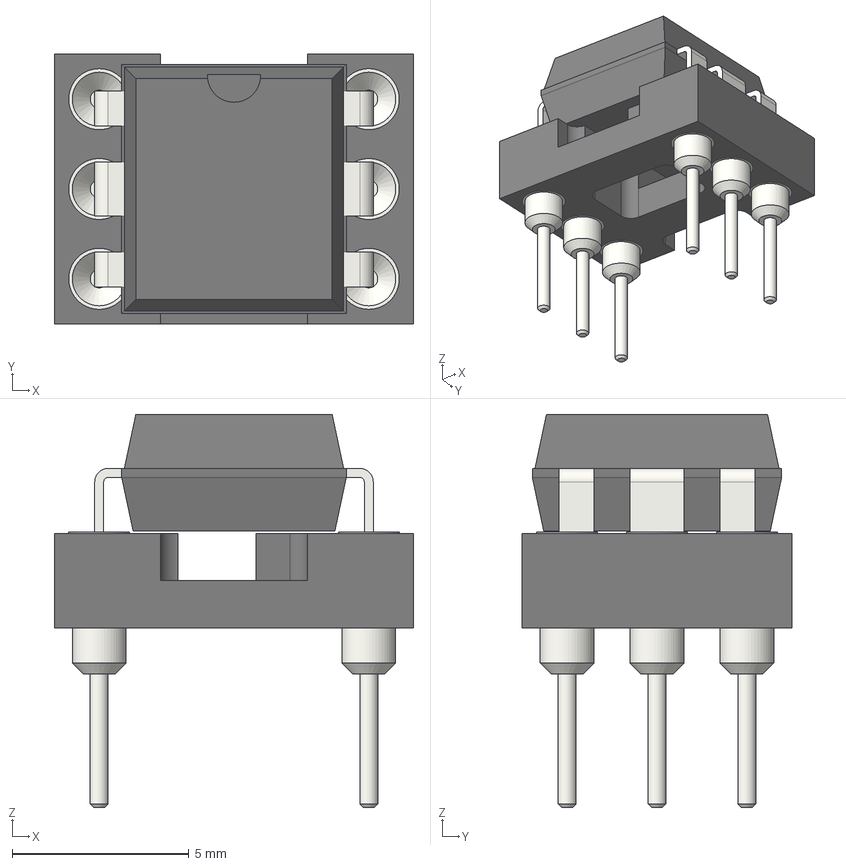
[picture p48: CAD file, 2019-02-25]
SA_3dshapes/ON_Semi_H11F1M/ON_Semi_H11F1M_Socketed.step
10.2 x 7.62 x 11.1 mm
