julessouren/kicad-library-sa/SA_3dshapes/ON_Semi_L78L09ABUTR_SOT-89/ON_Semi_L78L09ABUTR-SOT-89.step

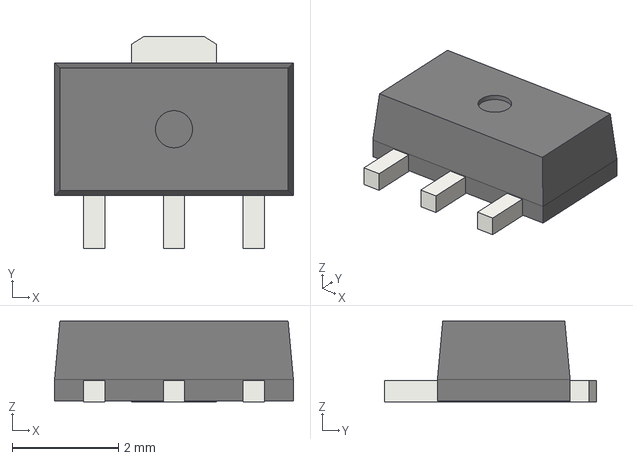
[picture p49: CAD file, 2018-12-28]
SA_3dshapes/ON_Semi_L78L09ABUTR_SOT-89/ON_Semi_L78L09ABUTR-SOT-89.step
4.50 x 4.00 x 1.52 mm
