julessouren/kicad-library-sa/SA_3dshapes/ON_Semi_MBT3946DW1T1G_SOT-363_SC-70-6_SC-80/ON_Semi_MBT3946DW1T1G_SOT-363_SC-70-6_SC-80.step

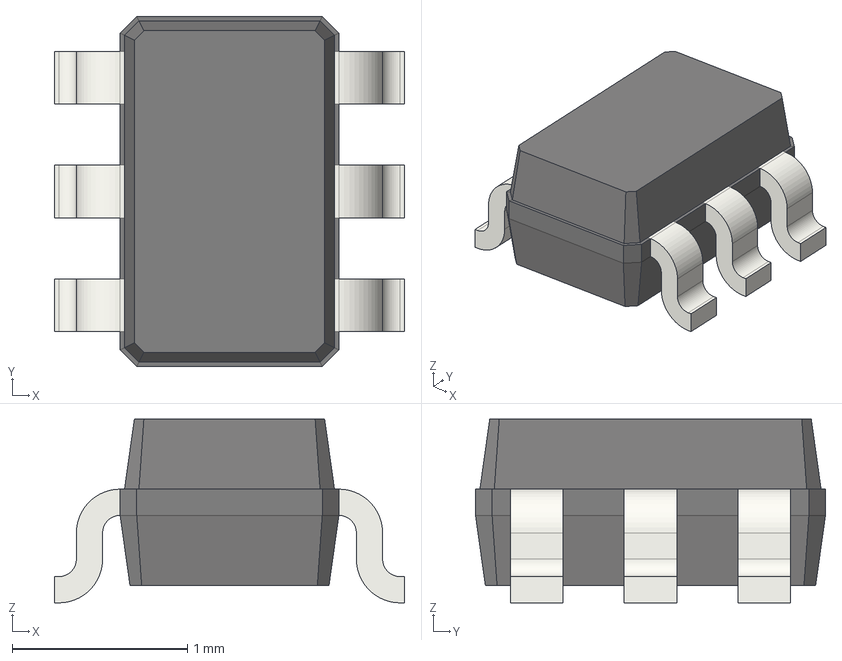
[picture p50: CAD file, 2018-12-28]
SA_3dshapes/ON_Semi_MBT3946DW1T1G_SOT-363_SC-70-6_SC-80/ON_Semi_MBT3946DW1T1G_SOT-363_SC-70-6_SC-80.step
2.00 x 2.00 x 1.05 mm
