julessouren/kicad-library-sa/SA_3dshapes/ON_Semi_MCH6341-TL-W_SOT-363_SC-70-6_SC-88/ON_Semi_MCH6341-TL-W_SOT-363_SC-70-6_SC-88.step

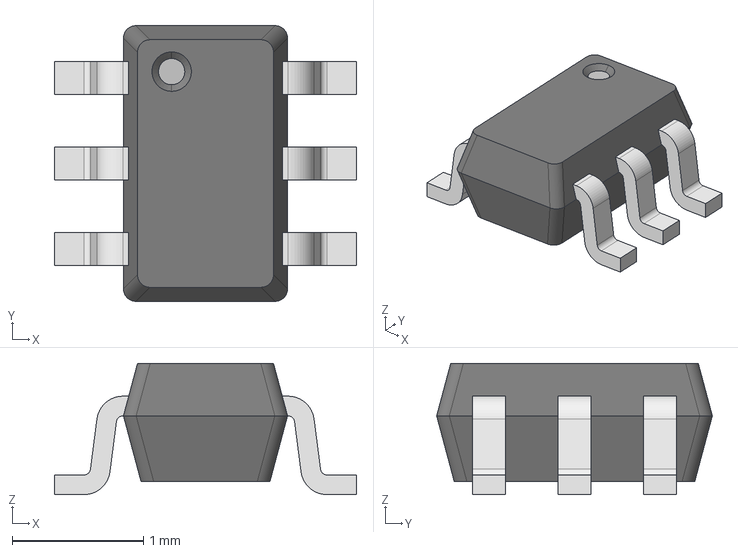
[picture p51: CAD file, 2018-12-26]
SA_3dshapes/ON_Semi_MCH6341-TL-W_SOT-363_SC-70-6_SC-88/ON_Semi_MCH6341-TL-W_SOT-363_SC-70-6_SC-88.step
2.30 x 2.10 x 1.00 mm
