julessouren/kicad-library-sa/SA_3dshapes/ON_Semi_MMBT3904TT1G_SOT-416-SC-75/ON_Semi_MMBT3904TT1G_SOT-416-SC-75.step

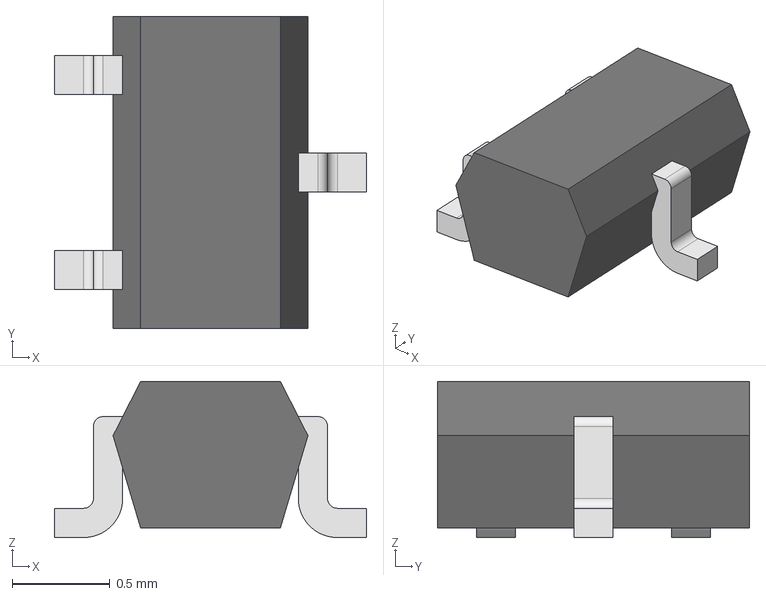
[picture p52: CAD file, 2018-12-28]
SA_3dshapes/ON_Semi_MMBT3904TT1G_SOT-416-SC-75/ON_Semi_MMBT3904TT1G_SOT-416-SC-75.step
1.60 x 1.60 x 0.8 mm
