julessouren/kicad-library-sa/SA_3dshapes/ON_Semi_MMBT5089LT1G_SOT-23/ON_Semi_MMBT5089LT1G_SOT-23.step

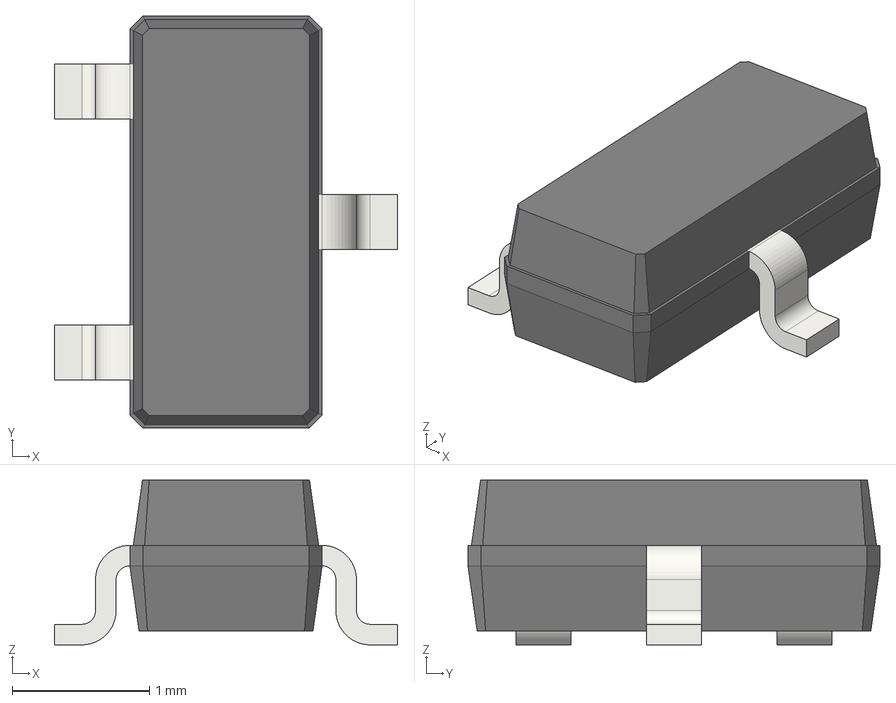
[picture p53: CAD file, 2018-12-28]
SA_3dshapes/ON_Semi_MMBT5089LT1G_SOT-23/ON_Semi_MMBT5089LT1G_SOT-23.step
2.50 x 3.00 x 1.20 mm
