julessouren/kicad-library-sa/SA_3dshapes/ON_Semi_NCP1117LPST50T3G_SOT-223-3/ON_Semi_NCP1117LPST50T3G_SOT-223-3.step

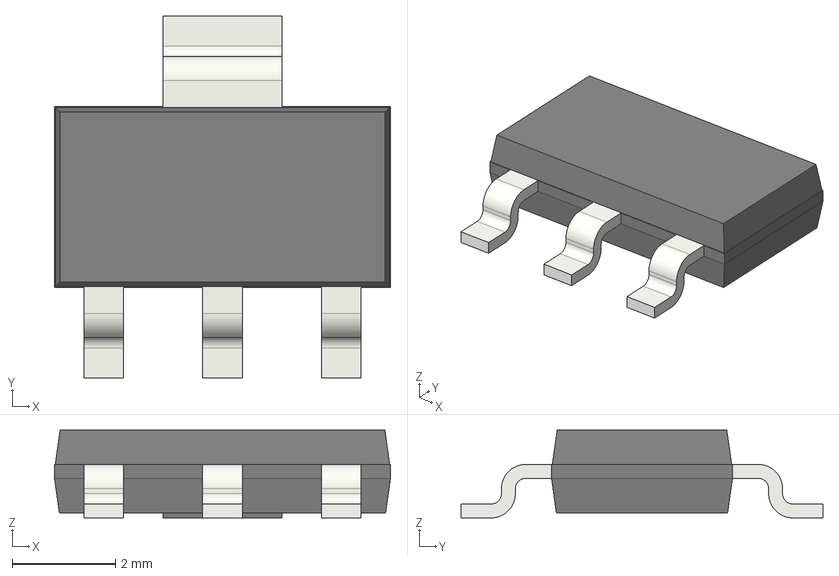
[picture p54: CAD file, 2018-12-28]
SA_3dshapes/ON_Semi_NCP1117LPST50T3G_SOT-223-3/ON_Semi_NCP1117LPST50T3G_SOT-223-3.step
6.50 x 7.00 x 1.70 mm
