julessouren/kicad-library-sa/SA_3dshapes/ON_Semi_NL37WZ14USG_US8-8/ON_Semi_NL37WZ14USG_US8-8.step

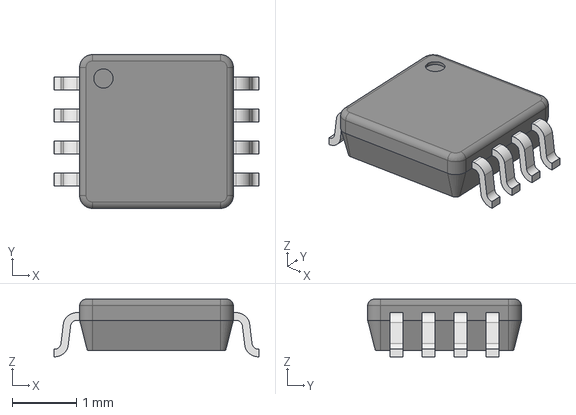
[picture p55: CAD file, 2018-12-26]
SA_3dshapes/ON_Semi_NL37WZ14USG_US8-8/ON_Semi_NL37WZ14USG_US8-8.step
3.20 x 2.40 x 0.9 mm
