julessouren/kicad-library-sa/SA_3dshapes/Packages/LED_5mm_Yellow_Cut_H4.5mm.step

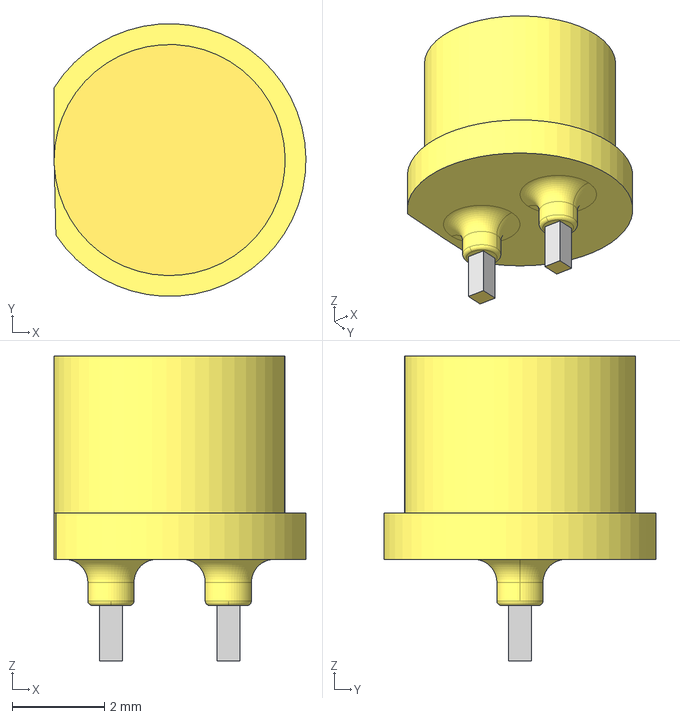
[picture p56: CAD file, 2019-04-16]
SA_3dshapes/Packages/LED_5mm_Yellow_Cut_H4.5mm.step
5.45 x 5.89 x 6.60 mm
