julessouren/kicad-library-sa/SA_3dshapes/Packages/pots/PDB182-GTR.stp

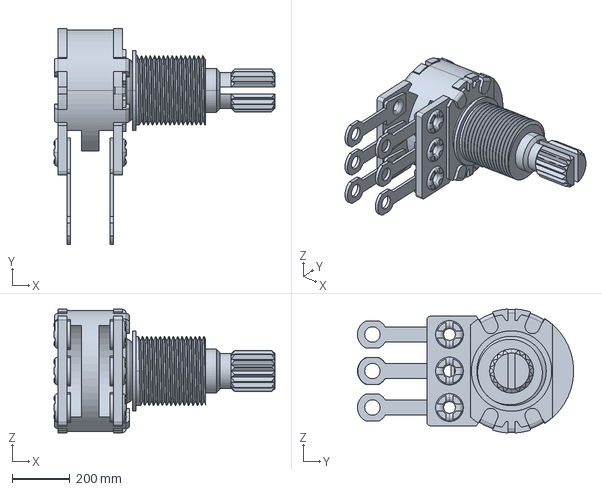
[picture p57: CAD file, 2019-03-04]
SA_3dshapes/Packages/pots/PDB182-GTR.stp
768.3 x 751.4 x 431.1 mm
