julessouren/kicad-library-sa/SA_3dshapes/Panasonic_TQ/Panasonic_TQ.stp

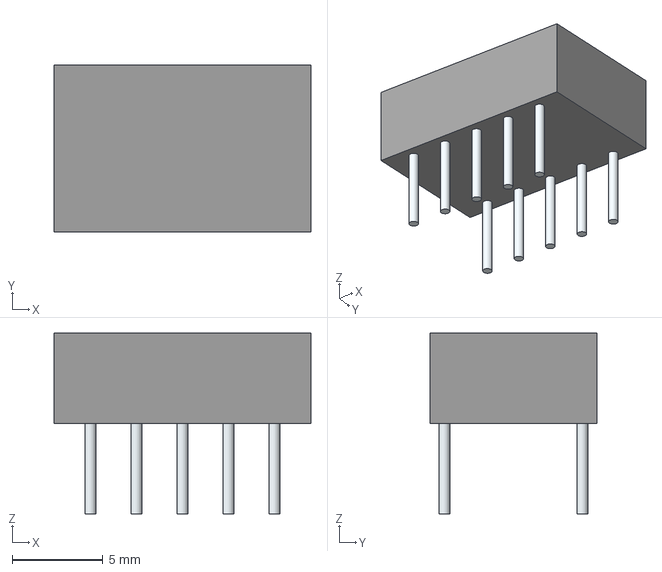
[picture p58: CAD file, 2018-12-28]
SA_3dshapes/Panasonic_TQ/Panasonic_TQ.stp
14.2 x 9.20 x 10.0 mm
Leads x 10
