julessouren/kicad-library-sa/SA_3dshapes/Preci-dip/Preci-dip_310-87-104-41-105101.step

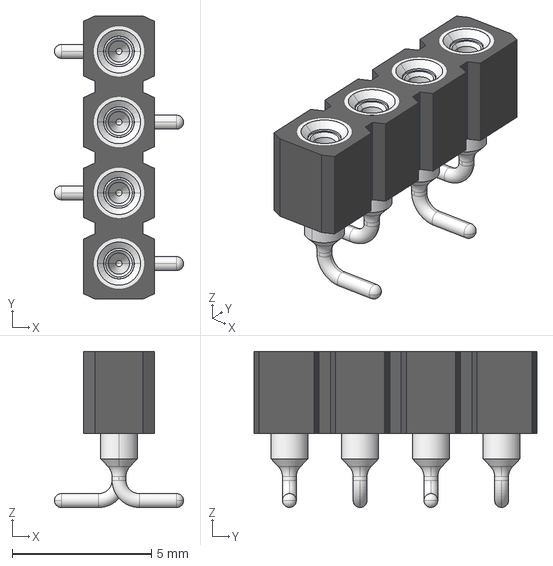
[picture p59: CAD file, 2019-02-26]
SA_3dshapes/Preci-dip/Preci-dip_310-87-104-41-105101.step
4.64 x 10.2 x 5.60 mm
