julessouren/kicad-library-sa/SA_3dshapes/ROHM_Semi_BU4S584G2-TR_SSOP-5/ROHM_Semi_BU4S584G2-TR_SSOP-5.stp

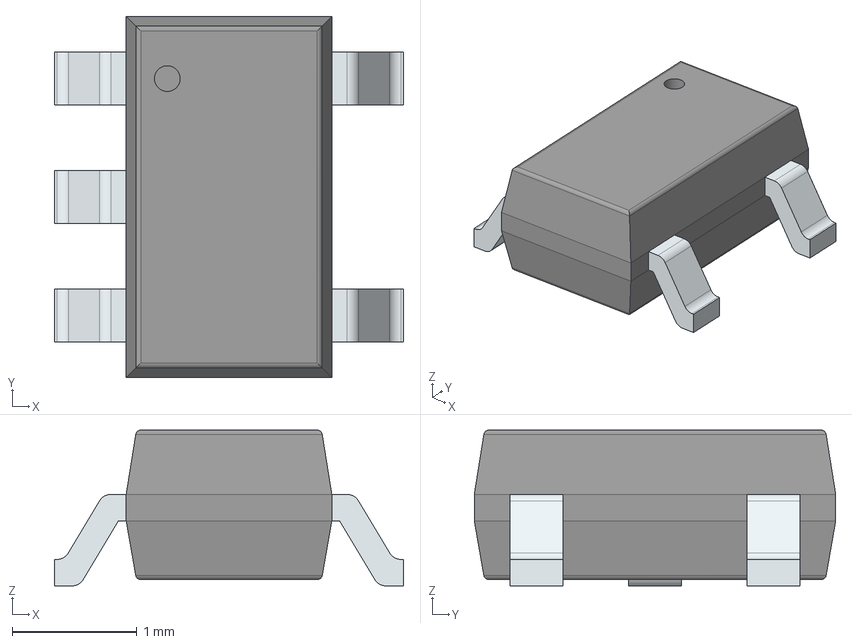
[picture p60: CAD file, 2019-02-05]
SA_3dshapes/ROHM_Semi_BU4S584G2-TR_SSOP-5/ROHM_Semi_BU4S584G2-TR_SSOP-5.stp
2.80 x 2.90 x 1.25 mm
PinsArrayL
PinsArrayR
