julessouren/kicad-library-sa/SA_3dshapes/Samtec_CLP_Pin_Headers/CLP_103_02_F_D.step

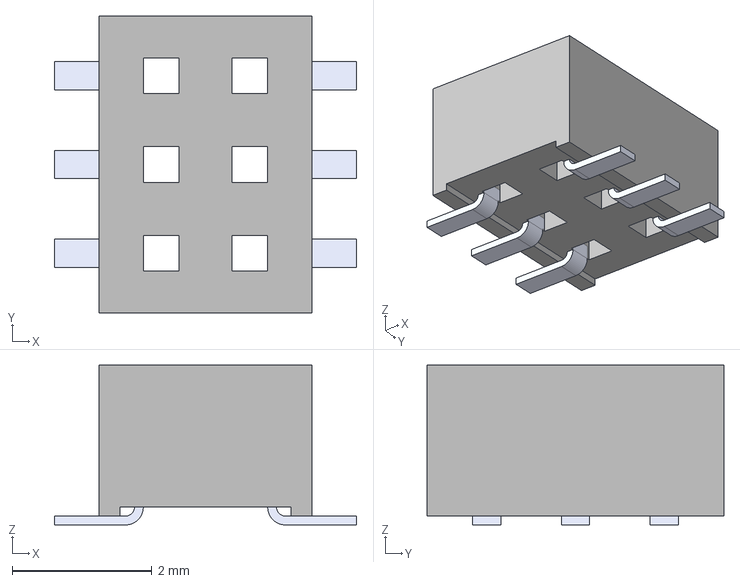
[picture p61: CAD file, 2019-04-16]
SA_3dshapes/Samtec_CLP_Pin_Headers/CLP_103_02_F_D.step
4.32 x 4.24 x 2.29 mm
