julessouren/kicad-library-sa/SA_3dshapes/Samtec_MTLW_Pin_Headers/MTLW-103-09-G-S-603.stp

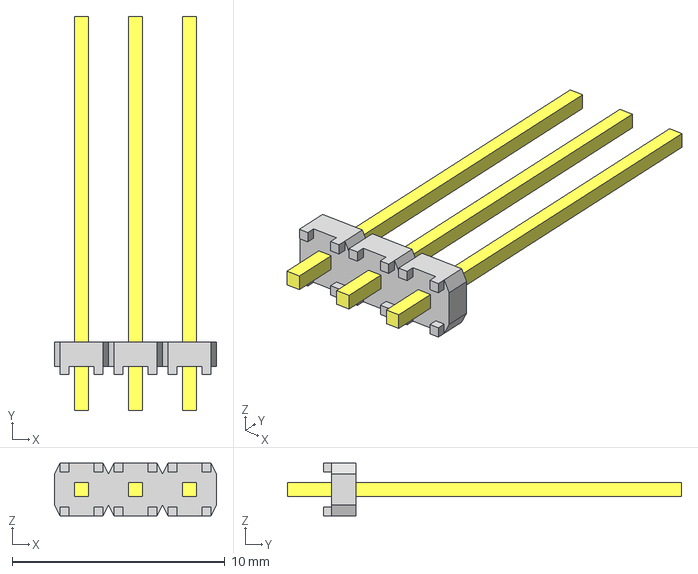
[picture p62: CAD file, 2019-04-16]
SA_3dshapes/Samtec_MTLW_Pin_Headers/MTLW-103-09-G-S-603.stp
7.62 x 18.5 x 2.49 mm
_MTLW-103-09-G-S-603_body
_MTLW-03-09-S-603
