julessouren/kicad-library-sa/SA_3dshapes/Samtec_SL_Pin_Sockets/SL-102-G-10.stp

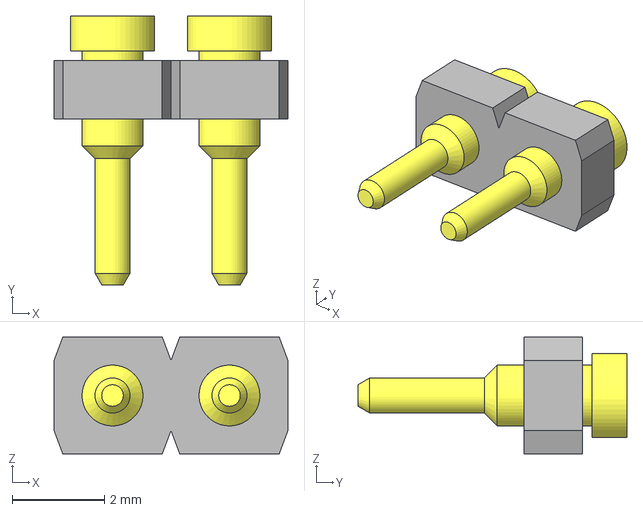
[picture p63: CAD file, 2019-02-25]
SA_3dshapes/Samtec_SL_Pin_Sockets/SL-102-G-10.stp
5.08 x 5.84 x 2.54 mm
_SL-102_socket
_SC-3P1_pins x 2
