julessouren/kicad-library-sa/SA_3dshapes/Samtec_SS_Pin_Sockets/SS-105-G-2.step

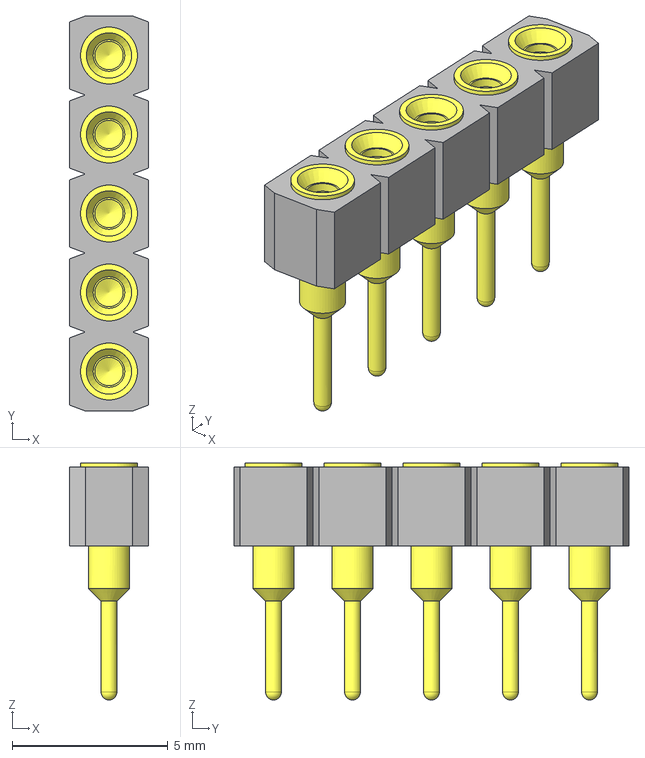
[picture p64: CAD file, 2019-02-25]
SA_3dshapes/Samtec_SS_Pin_Sockets/SS-105-G-2.step
2.54 x 12.7 x 7.62 mm
