julessouren/kicad-library-sa/SA_3dshapes/Switchcraft_250/Switxhcraft_250.step

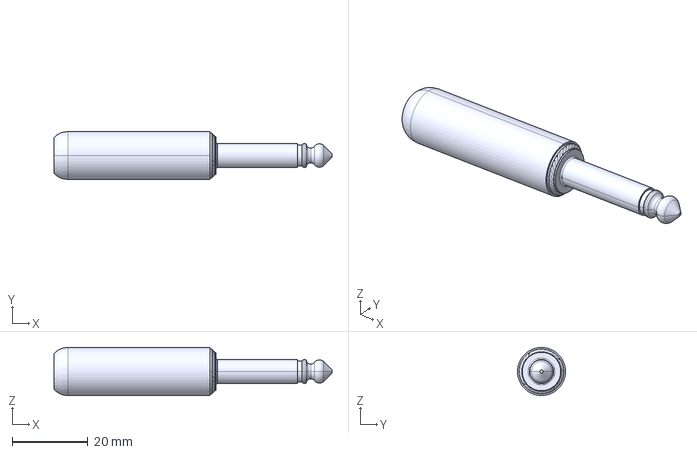
[picture p65: CAD file, 2019-02-25]
SA_3dshapes/Switchcraft_250/Switxhcraft_250.step
73.5 x 12.7 x 12.7 mm
