julessouren/kicad-library-sa/SA_3dshapes/Tayda/Tayda_Slide_Switch_1P2T.step

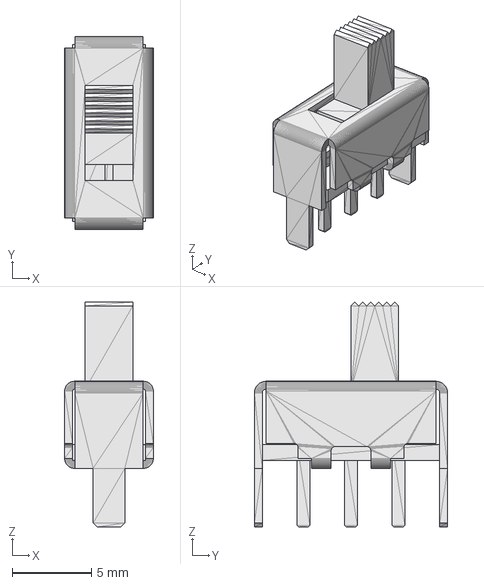
[picture p66: CAD file, 2019-03-04]
SA_3dshapes/Tayda/Tayda_Slide_Switch_1P2T.step
5.60 x 12.2 x 14.2 mm
