julessouren/kicad-library-sa/SA_3dshapes/Texas_Instruments_CD40106BE/Texas_Instruments_CD40106BE.step

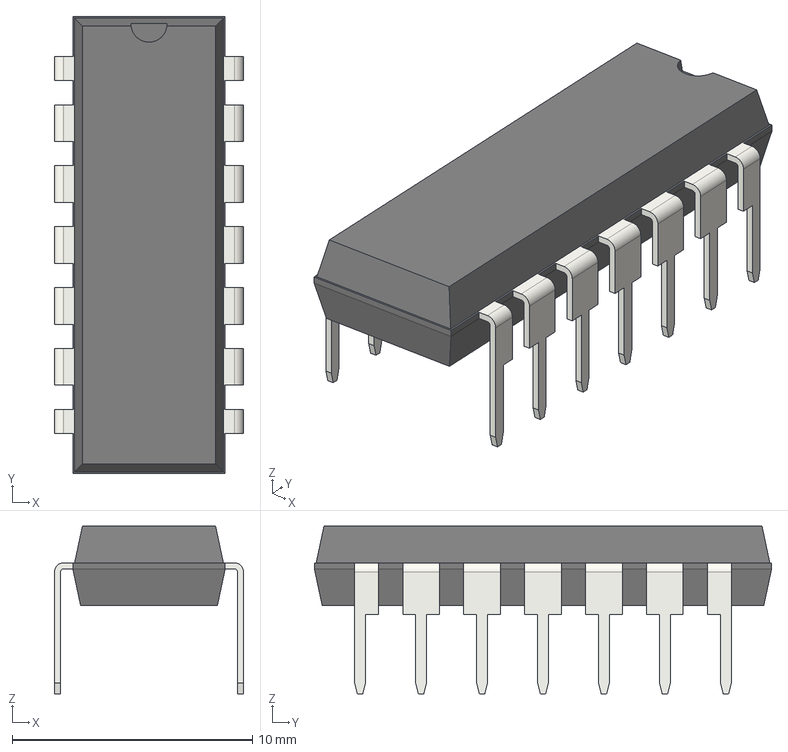
[picture p67: CAD file, 2018-12-31]
SA_3dshapes/Texas_Instruments_CD40106BE/Texas_Instruments_CD40106BE.step
7.87 x 19.1 x 6.98 mm
