julessouren/kicad-library-sa/SA_3dshapes/Texas_Instruments_CD40106BM_SOIC-14/Texas_Instruments_CD40106BM_SOIC-14.step

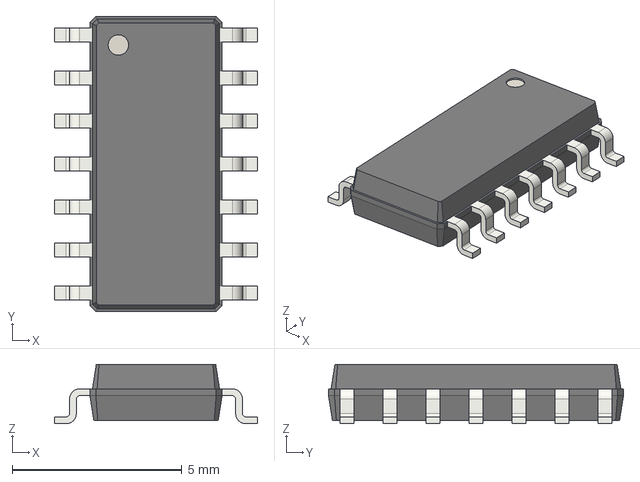
[picture p68: CAD file, 2019-02-05]
SA_3dshapes/Texas_Instruments_CD40106BM_SOIC-14/Texas_Instruments_CD40106BM_SOIC-14.step
6.00 x 8.70 x 1.75 mm
