julessouren/kicad-library-sa/SA_3dshapes/Texas_Instruments_CD40106BPWR_TSSOP-14/Texas_Instruments_CD40106BPWR_TSSOP-14_Markings.step

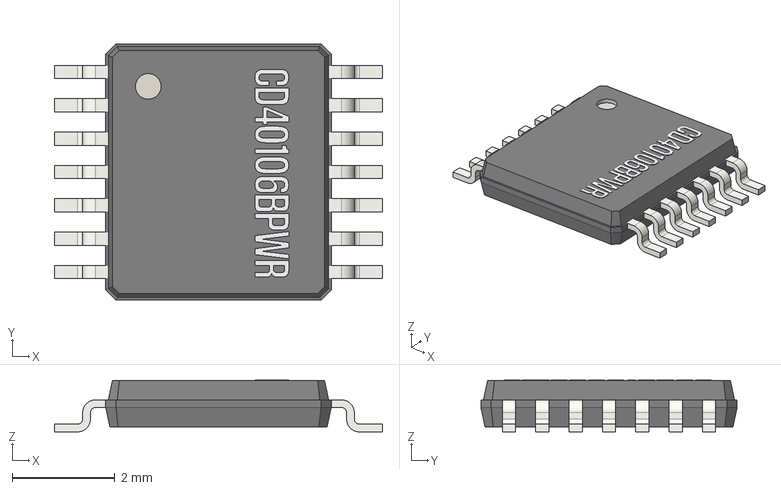
[picture p69: CAD file, 2019-07-16]
SA_3dshapes/Texas_Instruments_CD40106BPWR_TSSOP-14/Texas_Instruments_CD40106BPWR_TSSOP-14_Markings.step
6.40 x 5.00 x 1.01 mm
