julessouren/kicad-library-sa/SA_3dshapes/Texas_Instruments_CD4049UBE/Texas_Instruments_CD4049UBE_Socketed.step

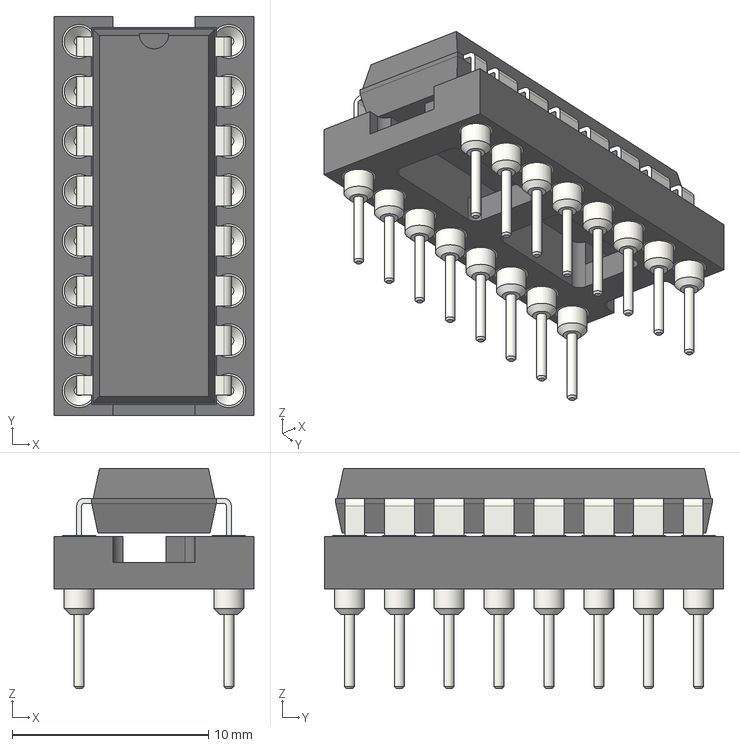
[picture p70: CAD file, 2018-12-31]
SA_3dshapes/Texas_Instruments_CD4049UBE/Texas_Instruments_CD4049UBE_Socketed.step
10.2 x 20.3 x 11.2 mm
