julessouren/kicad-library-sa/SA_3dshapes/Texas_Instruments_CD4053BE/Texas_Instruments_CD4053BE.step

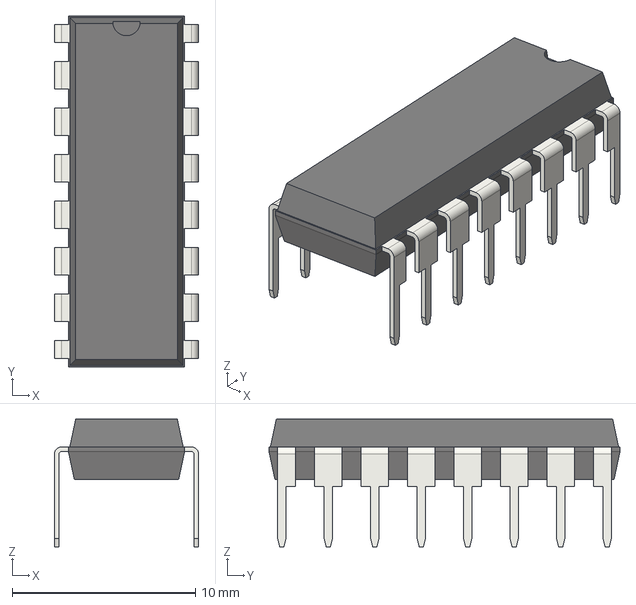
[picture p71: CAD file, 2018-12-31]
SA_3dshapes/Texas_Instruments_CD4053BE/Texas_Instruments_CD4053BE.step
7.87 x 19.2 x 6.98 mm
