julessouren/kicad-library-sa/SA_3dshapes/Texas_Instruments_CD4069UBE/Texas_Instruments_CD4069UBE_Socketed.step

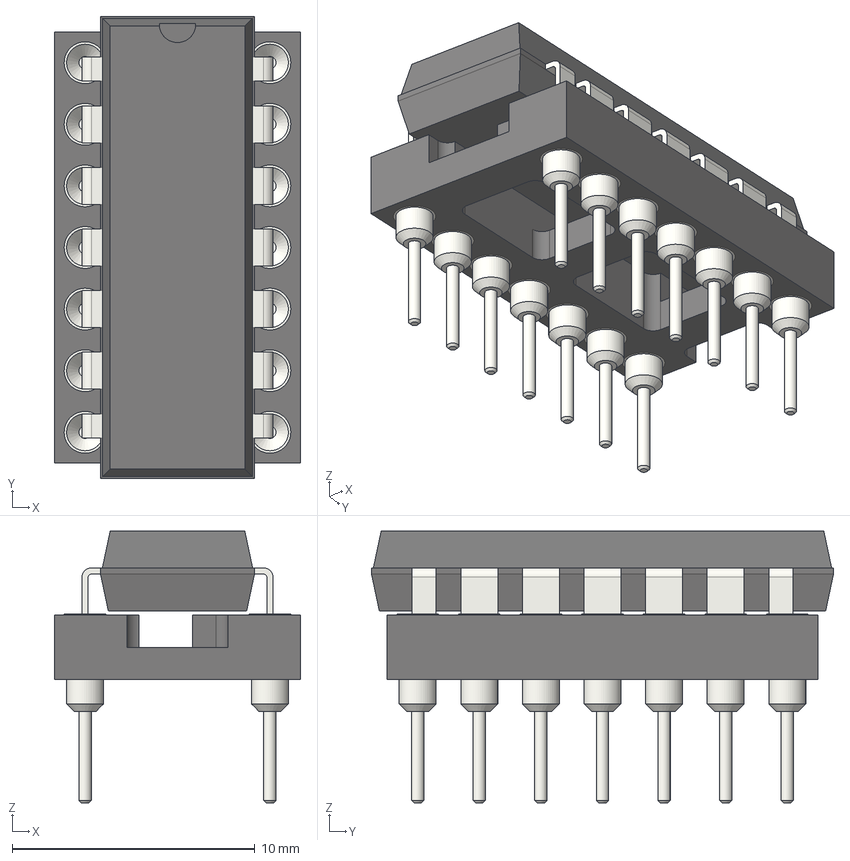
[picture p72: CAD file, 2018-12-31]
SA_3dshapes/Texas_Instruments_CD4069UBE/Texas_Instruments_CD4069UBE_Socketed.step
10.2 x 19.1 x 11.2 mm
