julessouren/kicad-library-sa/SA_3dshapes/Texas_Instruments_SN74LVC3G14DCTR_SM8_DCT_SSOP-8/Texas_Instruments_SN74LVC3G14DCTR_SM8_DCT_SSOP-8.step

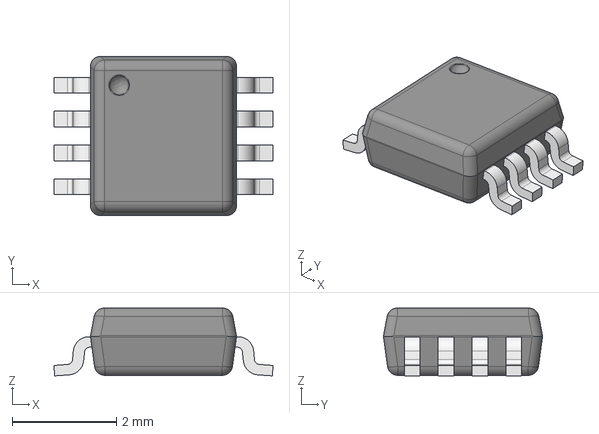
[picture p73: CAD file, 2018-12-26]
SA_3dshapes/Texas_Instruments_SN74LVC3G14DCTR_SM8_DCT_SSOP-8/Texas_Instruments_SN74LVC3G14DCTR_SM8_DCT_SSOP-8.step
4.20 x 3.05 x 1.30 mm
