julessouren/kicad-library-sa/SA_3dshapes/Toshiba_TLP222A(F)/Toshiba_TLP222A(F)_Socketed_DIP-6.step

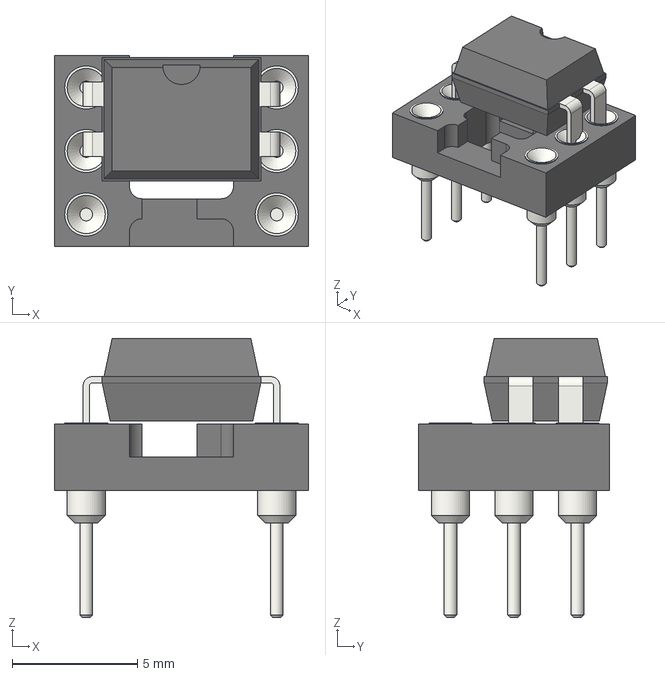
[picture p74: CAD file, 2019-02-25]
SA_3dshapes/Toshiba_TLP222A(F)/Toshiba_TLP222A(F)_Socketed_DIP-6.step
10.2 x 7.62 x 11.2 mm
