julessouren/kicad-library-sa/SA_3dshapes/Wima/User_Library_CAPRR500W50L720T300H750_WIMA_1B_sp.step

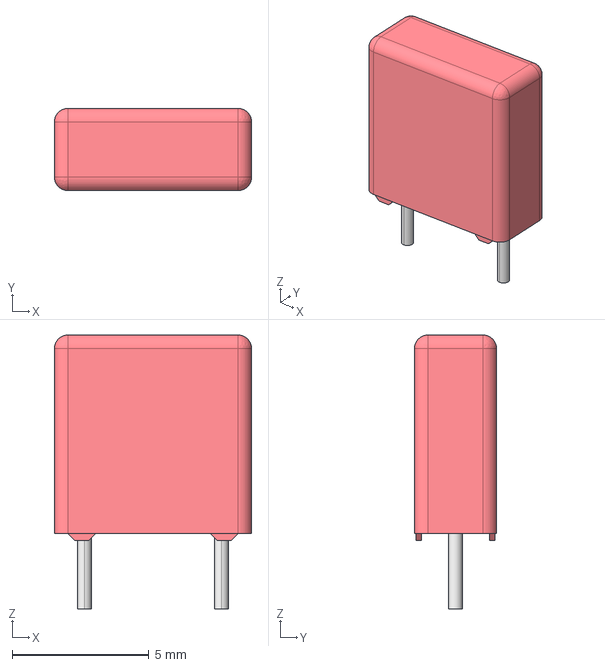
[picture p75: CAD file, 2018-12-31]
SA_3dshapes/Wima/User_Library_CAPRR500W50L720T300H750_WIMA_1B_sp.step
7.20 x 3.00 x 10.0 mm
