julessouren/kicad-library-sa/SA_3dshapes/WIMA_FKP2J001001D00JSSD_100pF_630V_L7.2_W4.5_H6.0_P5.0/WIMA_FKP2J001001D00JSSD_100pF_630V_L7.2_W4.5_H6.0_P5.0.step

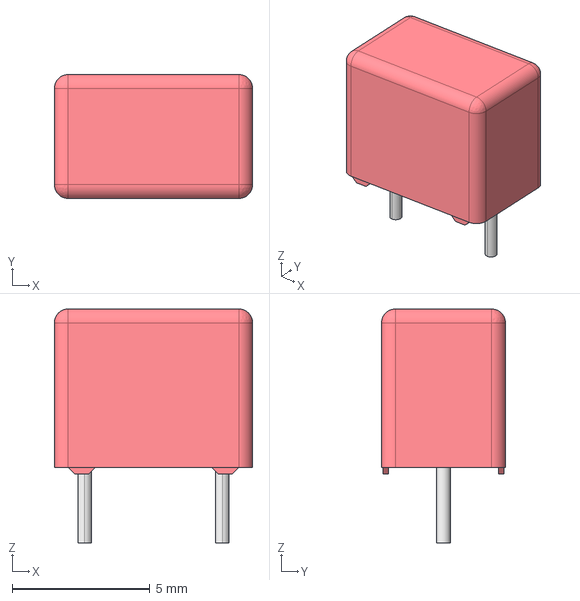
[picture p76: CAD file, 2018-12-31]
SA_3dshapes/WIMA_FKP2J001001D00JSSD_100pF_630V_L7.2_W4.5_H6.0_P5.0/WIMA_FKP2J001001D00JSSD_100pF_630V_L7.2_W4.5_H6.0_P5.0.step
7.20 x 4.50 x 8.50 mm
