julessouren/kicad-library-sa/SA_3dshapes/Wima_FKS2G011001A00KSSD_1.0nF_400V_L7.2_W2.5_H6.5_P5.0/Wima_FKS2G011001A00KSSD_1.0nF_400V_L7.2_W2.5_H6.5_P5.0.step

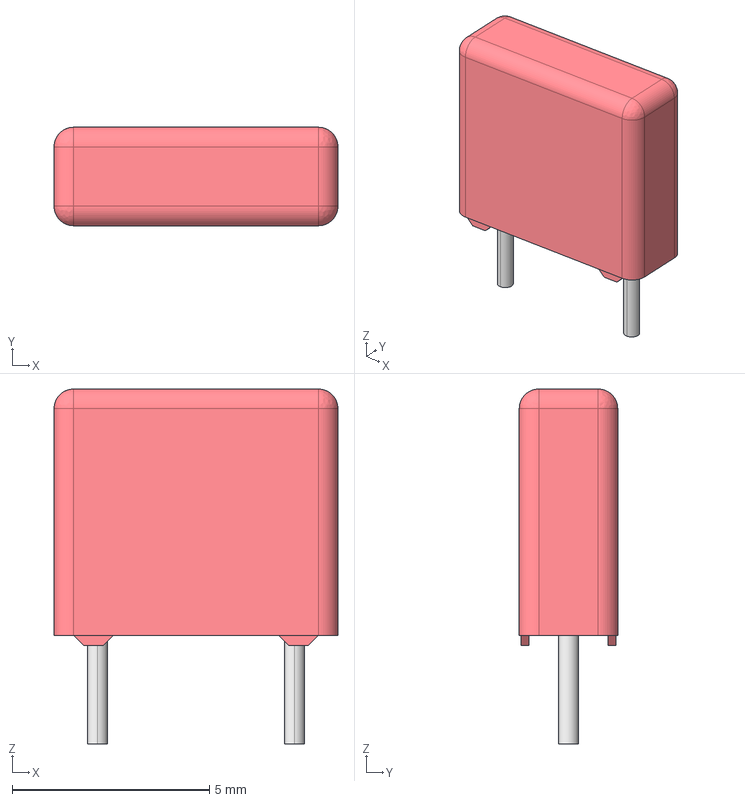
[picture p77: CAD file, 2018-12-31]
SA_3dshapes/Wima_FKS2G011001A00KSSD_1.0nF_400V_L7.2_W2.5_H6.5_P5.0/Wima_FKS2G011001A00KSSD_1.0nF_400V_L7.2_W2.5_H6.5_P5.0.step
7.20 x 2.50 x 9.00 mm
