julessouren/kicad-library-sa/SA_3dshapes/Wima_FKS2G021001C00KSSD_10nF_400V_L7.2_W3.5_H8.5_P5.0/Wima_FKS2G021001C00KSSD_10nF_400V_L7.2_W3.5_H8.5_P5.0.step

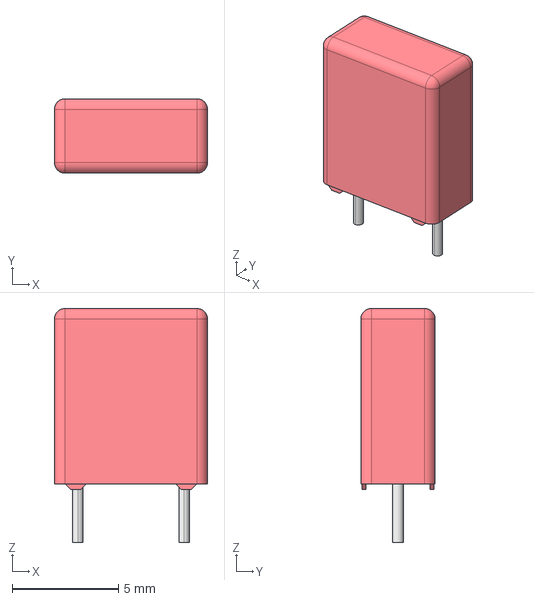
[picture p78: CAD file, 2018-12-31]
SA_3dshapes/Wima_FKS2G021001C00KSSD_10nF_400V_L7.2_W3.5_H8.5_P5.0/Wima_FKS2G021001C00KSSD_10nF_400V_L7.2_W3.5_H8.5_P5.0.step
7.20 x 3.50 x 11.0 mm
