julessouren/kicad-library-sa/SA_3dshapes/Wima_MKS2C041001F00KSSD_1.0uF_63V_L7.2_W5.0_H10.0_P5.0/Wima_MKS2C041001F00KSSD_1.0uF_63V_L7.2_W5.0_H10.0_P5.0.step

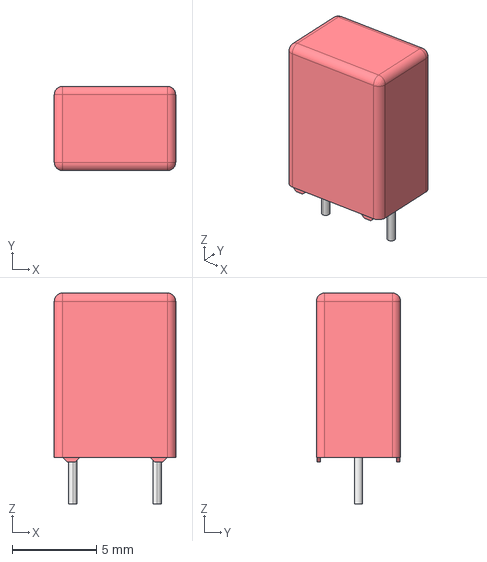
[picture p79: CAD file, 2018-12-31]
SA_3dshapes/Wima_MKS2C041001F00KSSD_1.0uF_63V_L7.2_W5.0_H10.0_P5.0/Wima_MKS2C041001F00KSSD_1.0uF_63V_L7.2_W5.0_H10.0_P5.0.step
7.20 x 5.00 x 12.5 mm
