julessouren/kicad-library-sa/SA_3dshapes/Wima_MKS2C042201K00KSSD_2.2uF_63V_L7.2_W7.2_H13.0_P5.0/Wima_MKS2C042201K00KSSD_2.2uF_63V_L7.2_W7.2_H13.0_P5.0.step

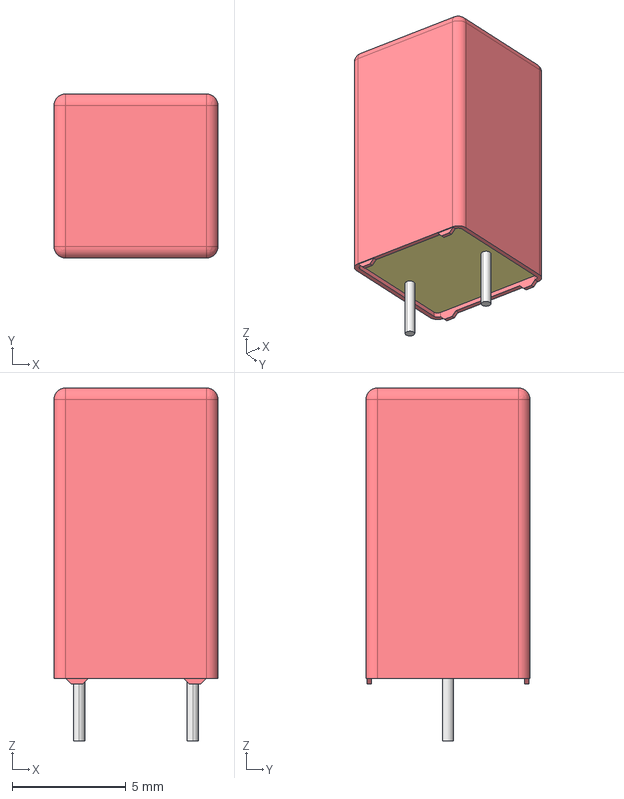
[picture p80: CAD file, 2018-12-31]
SA_3dshapes/Wima_MKS2C042201K00KSSD_2.2uF_63V_L7.2_W7.2_H13.0_P5.0/Wima_MKS2C042201K00KSSD_2.2uF_63V_L7.2_W7.2_H13.0_P5.0.step
7.20 x 7.20 x 15.5 mm
