julessouren/kicad-library-sa/SA_3dshapes/Wima_MKS2F031001E00KSSD_100nF_250V_L7.2_W4.5_H9.5_P5.0/Wima_MKS2F031001E00KSSD_100nF_250V_L7.2_W4.5_H9.5_P5.0.step

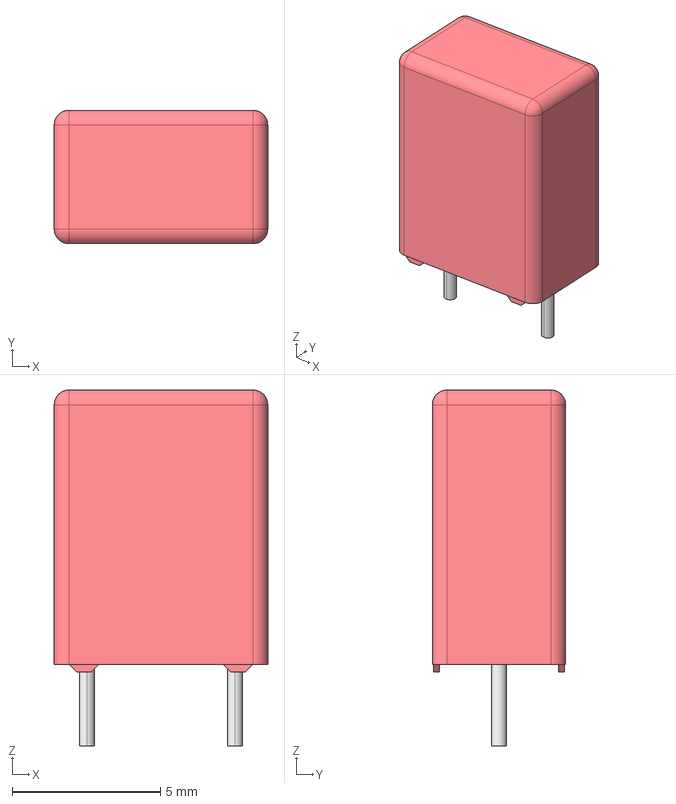
[picture p81: CAD file, 2018-12-31]
SA_3dshapes/Wima_MKS2F031001E00KSSD_100nF_250V_L7.2_W4.5_H9.5_P5.0/Wima_MKS2F031001E00KSSD_100nF_250V_L7.2_W4.5_H9.5_P5.0.step
7.20 x 4.50 x 12.0 mm
