julessouren/kicad-library-sa/SA_3dshapes/Atmel_ATtiny13A-PU/Atmel_ATtiny13A-PU.step

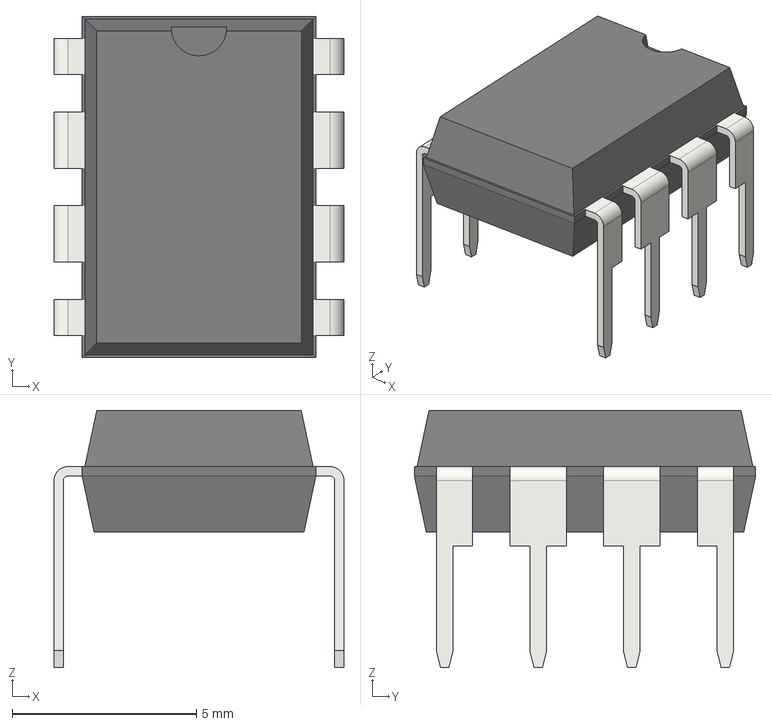
[picture p82: CAD file, 2018-12-28]
SA_3dshapes/Atmel_ATtiny13A-PU/Atmel_ATtiny13A-PU.step
7.87 x 9.27 x 6.98 mm
