julessouren/kicad-library-sa/SA_3dshapes/C&K_7101SYZBE/C&K_7101SYZBE.step

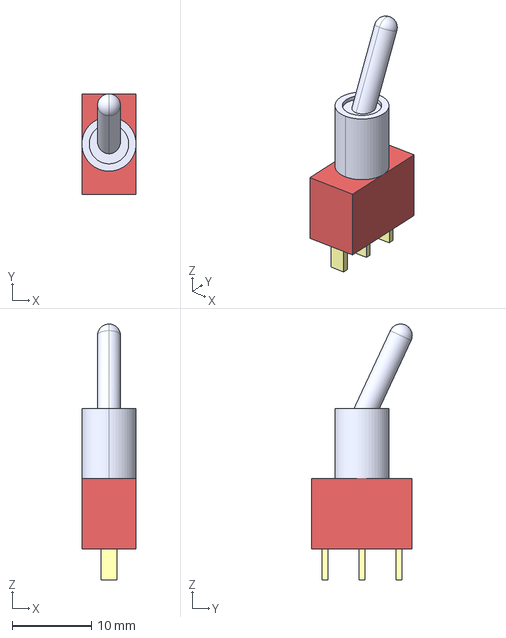
[picture p83: CAD file, 2019-03-04]
SA_3dshapes/C&K_7101SYZBE/C&K_7101SYZBE.step
6.86 x 12.7 x 32.4 mm
