julessouren/kicad-library-sa/SA_3dshapes/Hammond_1590BB/1590BB.stp

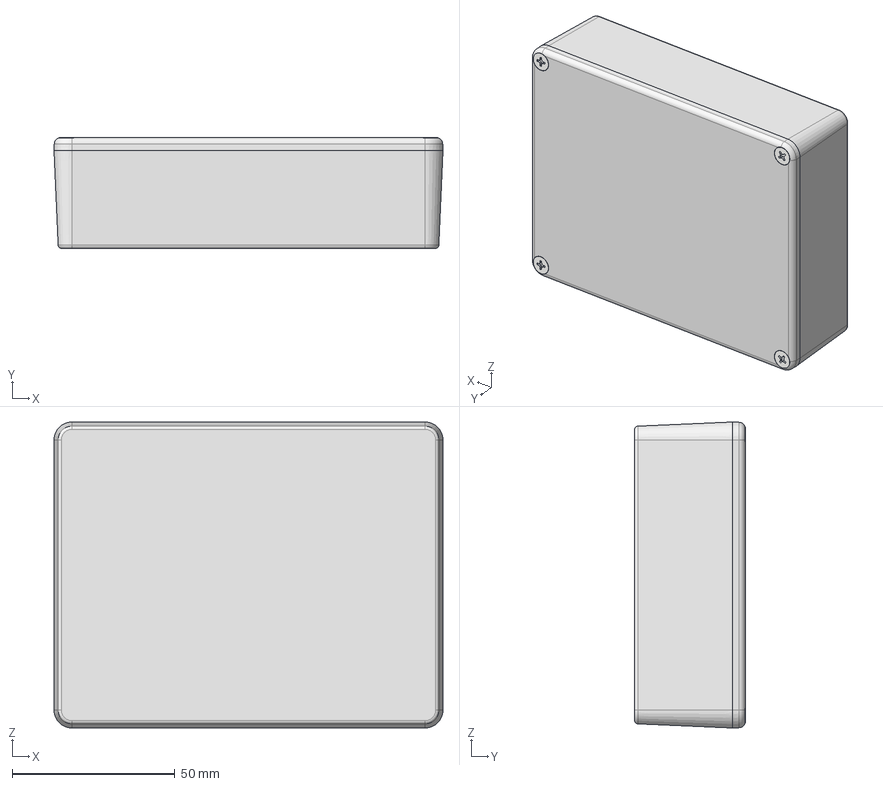
[picture p84: CAD file, 2019-02-08]
SA_3dshapes/Hammond_1590BB/1590BB.stp
119.5 x 34.0 x 94.0 mm
