julessouren/kicad-library-sa/SA_3dshapes/Hardware/Hex Spacers/Hex Spacer MF M3 L17mm.stp

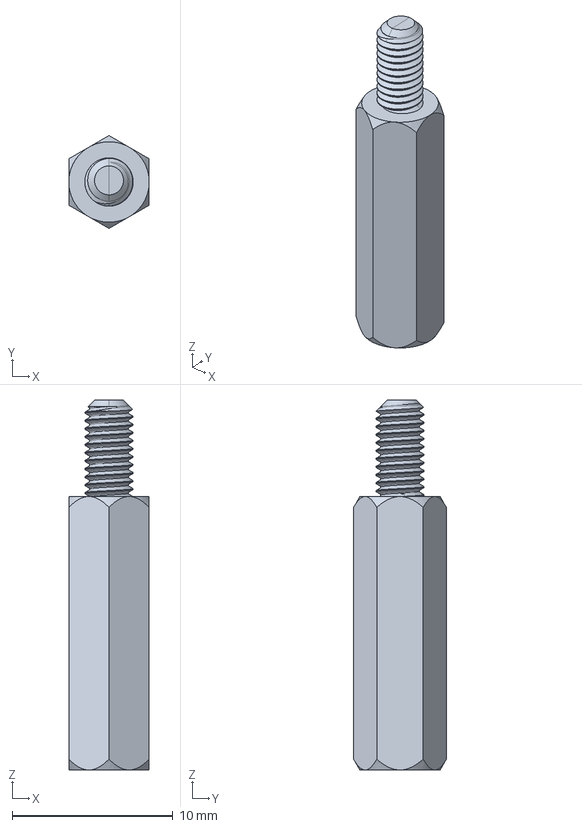
[picture p85: CAD file, 2019-04-16]
SA_3dshapes/Hardware/Hex Spacers/Hex Spacer MF M3 L17mm.stp
5.00 x 5.77 x 23.0 mm
