julessouren/kicad-library-sa/SA_3dshapes/Kemet_EA2-5NJ/Kemet_EA2-5NJ.step

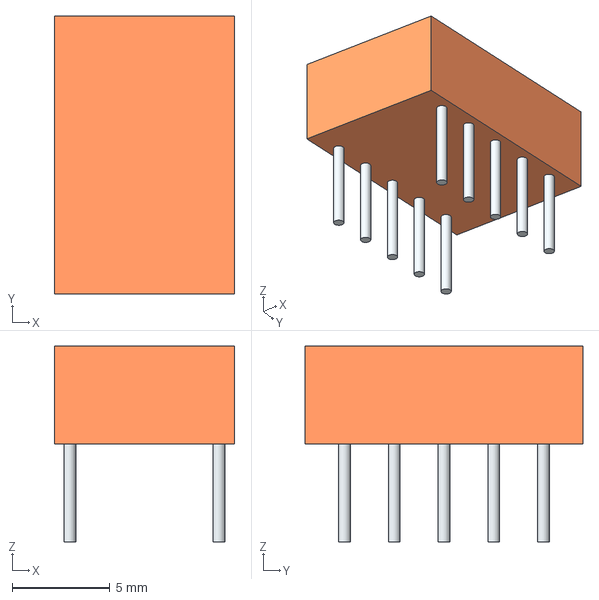
[picture p86: CAD file, 2019-02-07]
SA_3dshapes/Kemet_EA2-5NJ/Kemet_EA2-5NJ.step
9.20 x 14.2 x 10.0 mm
