julessouren/kicad-library-sa/SA_3dshapes/Knobs/mutron-16mm.step

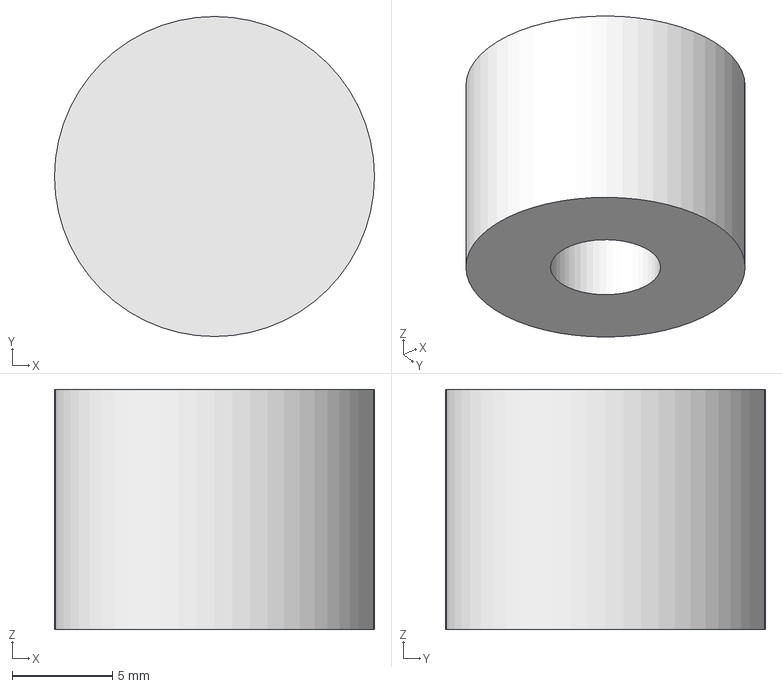
[picture p87: CAD file, 2019-04-16]
SA_3dshapes/Knobs/mutron-16mm.step
16.0 x 16.0 x 12.0 mm
