julessouren/kicad-library-sa/SA_3dshapes/Knobs/vol control/12.8 INNER.SLDPRT

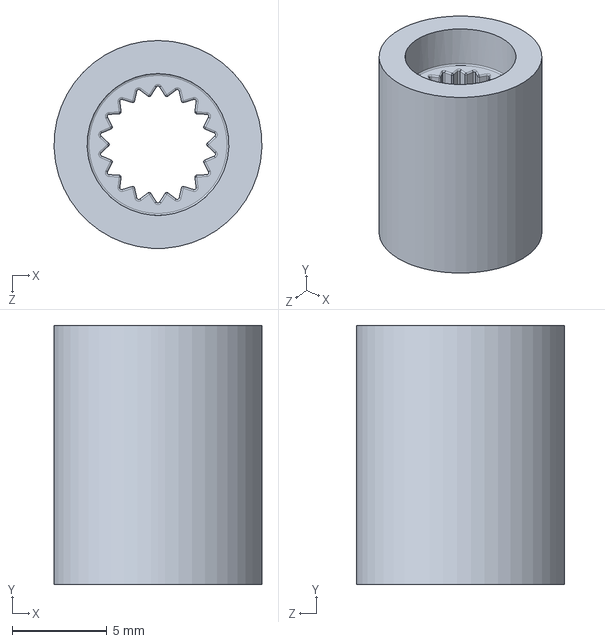
[picture p88: CAD file, 2019-04-16]
SA_3dshapes/Knobs/vol control/12.8 INNER.SLDPRT
11.0 x 13.7 x 11.0 mm
