julessouren/kicad-library-sa/SA_3dshapes/Lumberg_KLBM_3/Lumberg_KLBM_3_z12.5_r270.step

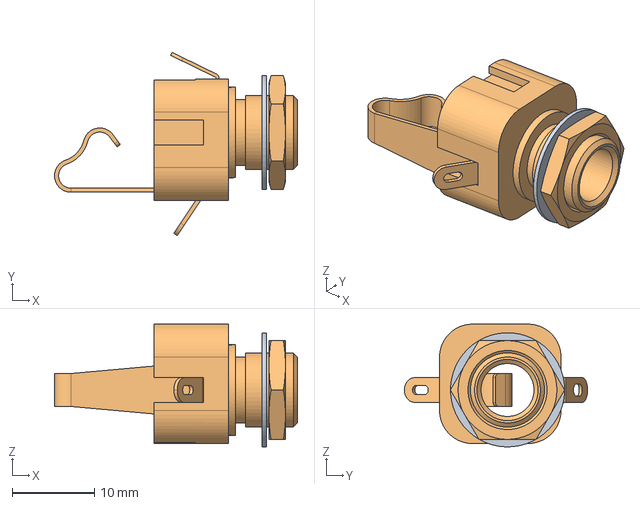
[picture p89: CAD file, 2019-02-25]
SA_3dshapes/Lumberg_KLBM_3/Lumberg_KLBM_3_z12.5_r270.step
29.5 x 22.2 x 14.9 mm
