julessouren/kicad-library-sa/SA_3dshapes/Neutrik_NMJ6HCD2/Neutrik_NMJ6HCD2_NoNose.step

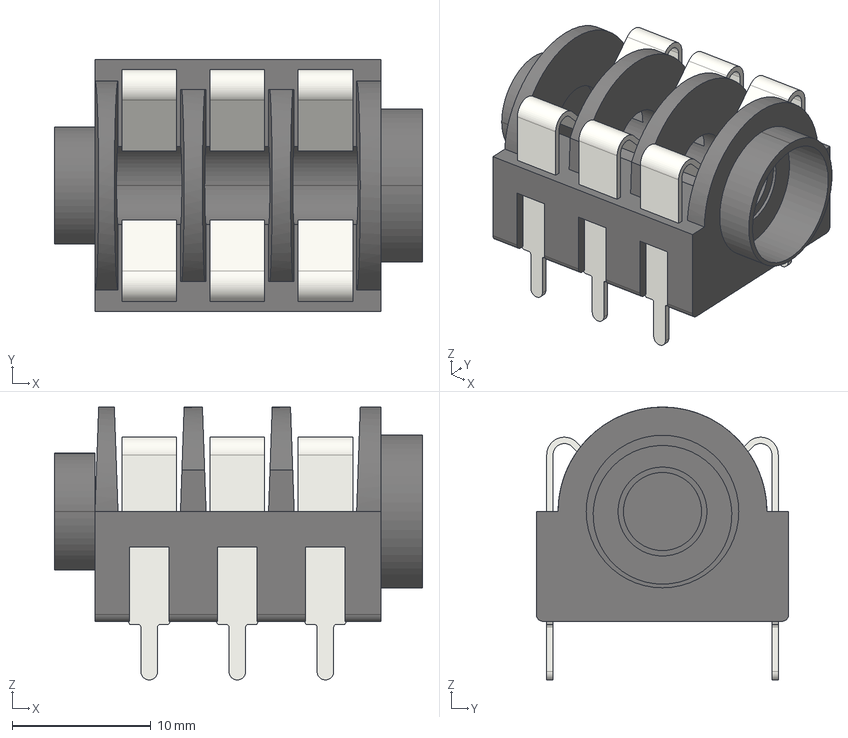
[picture p90: CAD file, 2019-06-19]
SA_3dshapes/Neutrik_NMJ6HCD2/Neutrik_NMJ6HCD2_NoNose.step
26.5 x 18.2 x 19.7 mm
