julessouren/kicad-library-sa/SA_3dshapes/ON_Semi_H11F1M/ON_Semi_H11F1M.step

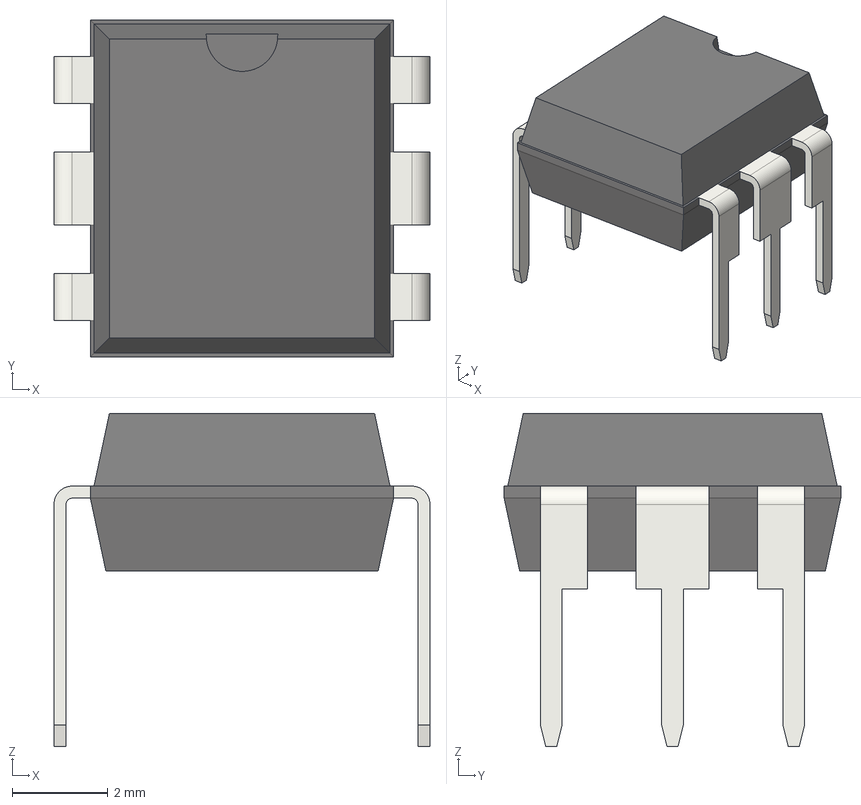
[picture p91: CAD file, 2019-02-25]
SA_3dshapes/ON_Semi_H11F1M/ON_Semi_H11F1M.step
7.87 x 7.05 x 6.98 mm
