julessouren/kicad-library-sa/SA_3dshapes/Packages/R_LDR_5_1x4_3mm_P3_4mm_Vertical_sp.step

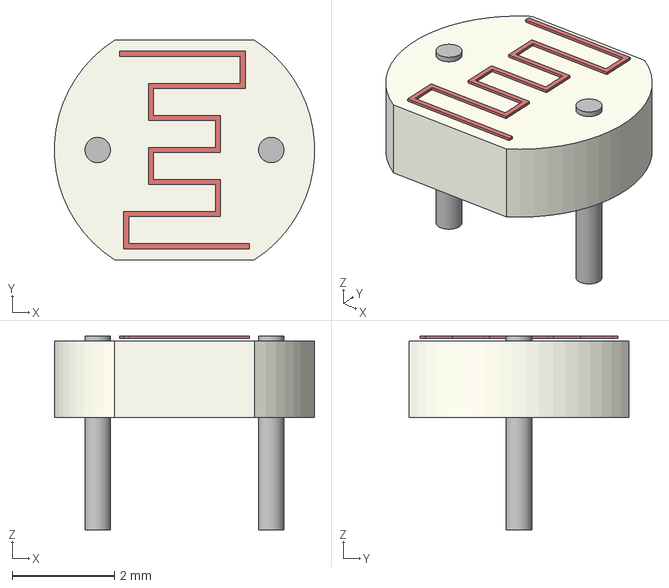
[picture p92: CAD file, 2019-04-16]
SA_3dshapes/Packages/R_LDR_5_1x4_3mm_P3_4mm_Vertical_sp.step
5.09 x 4.30 x 3.80 mm
