julessouren/kicad-library-sa/SA_3dshapes/Preci-dip/Preci-dip_310-87-105-41-105101.step

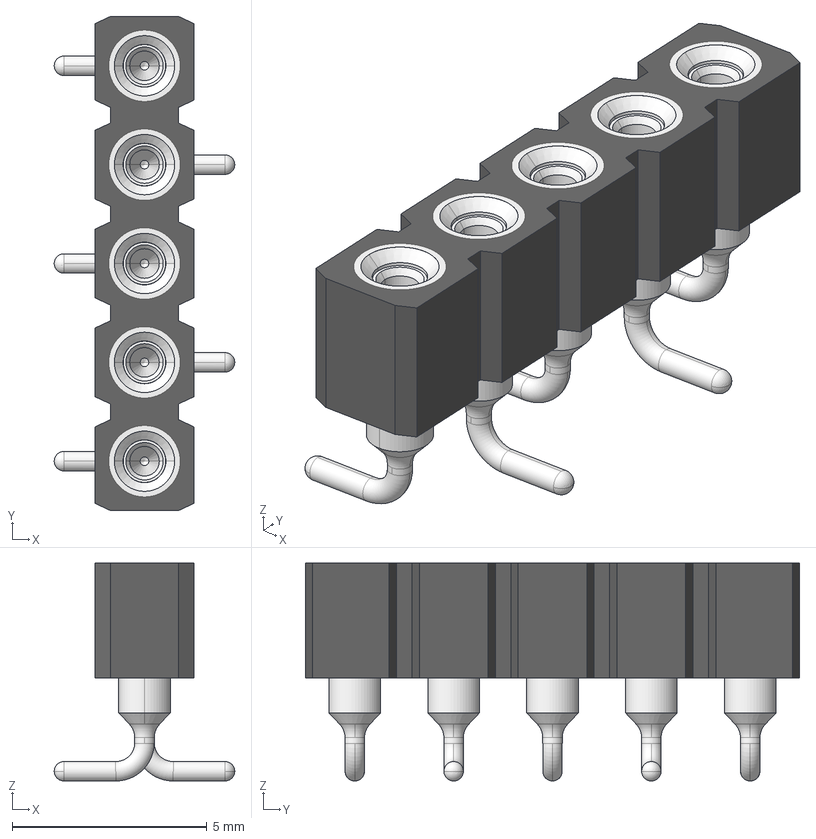
[picture p93: CAD file, 2019-02-26]
SA_3dshapes/Preci-dip/Preci-dip_310-87-105-41-105101.step
4.64 x 12.7 x 5.60 mm
