julessouren/kicad-library-sa/SA_3dshapes/Samtec_SS_Pin_Sockets/SS-102-G-2.step

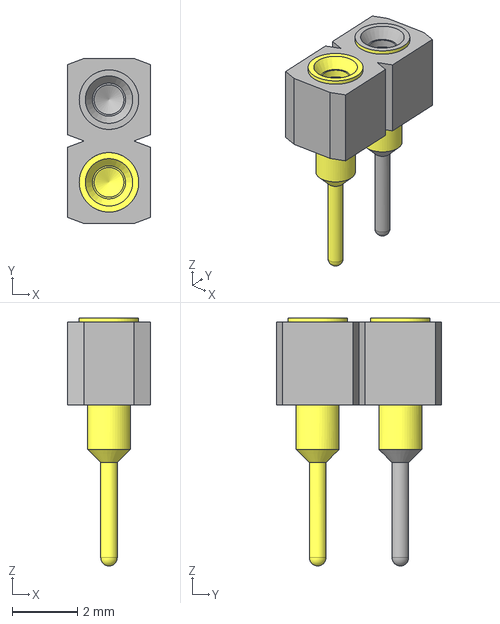
[picture p95: CAD file, 2019-02-25]
SA_3dshapes/Samtec_SS_Pin_Sockets/SS-102-G-2.step
2.54 x 5.08 x 7.62 mm
