julessouren/kicad-library-sa/SA_3dshapes/Tayda/MTS-102.IGS

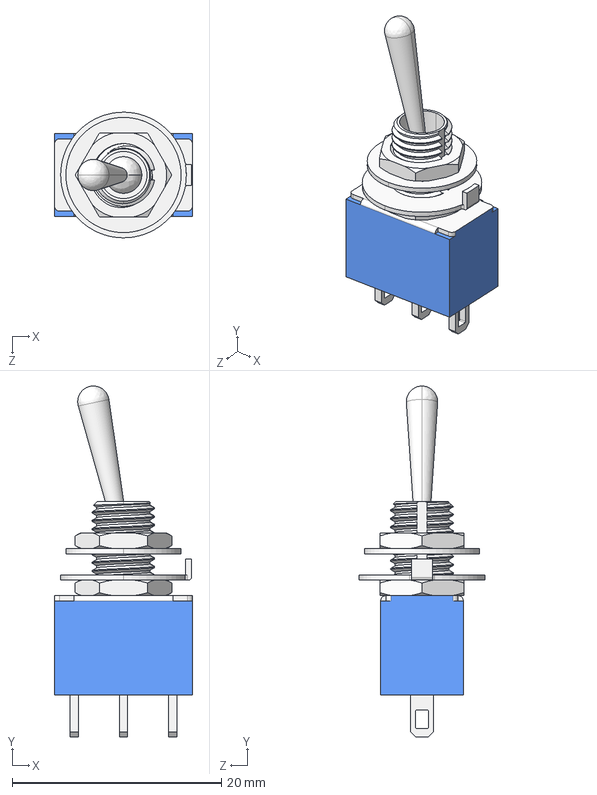
[picture p96: CAD file, 2019-03-04]
SA_3dshapes/Tayda/MTS-102.IGS
13.2 x 33.5 x 12.0 mm
