julessouren/kicad-library-sa/SA_3dshapes/Toshiba_TLP222A(F)/Toshiba_TLP222A(F)_Socketed.step

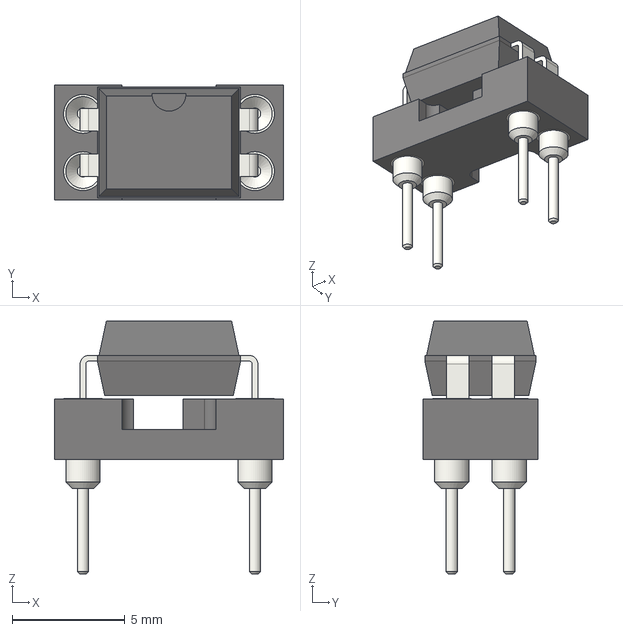
[picture p97: CAD file, 2018-12-28]
SA_3dshapes/Toshiba_TLP222A(F)/Toshiba_TLP222A(F)_Socketed.step
10.2 x 5.08 x 11.2 mm
