julessouren/kicad-library-sa/(list of files, cad)

Other CAD files:
SA_3dshapes/Alpha_Taiwan_RV16AF-41/rv16af-41-rhino-export-step.stp
SA_3dshapes/Alpha_Taiwan_RD901F-20/Alpha_Taiwan_RD901F-20-15R.step
SA_3dshapes/Alpha_Taiwan_RV16A01F-10/Stereo_Pot.IGS
SA_3dshapes/Alpha_Taiwan_RV16A01F-20/Alpha_Taiwan_RV16A01F-20.step
SA_3dshapes/Alpha_Taiwan_RV16AF-20/Alpha_Taiwan_RV16AF-20_Side.step
SA_3dshapes/Alpha_Taiwan_RV16AF-41/rv16-iges.igs
SA_3dshapes/Hammond_1590A/Lumberg_NEB_J_21_C.stp
SA_3dshapes/Hammond_1590B/1590B_NoLid_Alpha_9mm_Vert.step
SA_3dshapes/Lumberg_1614_09/Lumberg_1614_09_Top.step
SA_3dshapes/Lumberg_NEB_J_21_C/Lumberg_NEB_J_21_C_Topview.step
SA_3dshapes/Packages/pots/User Library-RV09ACF-40_RK09K1130A5R.STEP
SA_3dshapes/Texas_Instruments_CD40106BPWR_TSSOP-14/Texas_Instruments_CD40106BPWR_TSSOP-14.step
SA_3dshapes/Alpha_Taiwan_RD901F-20/Alpha_Taiwan_RD901F-20-15R_Side.step
SA_3dshapes/Alpha_Taiwan_RD901F-20/Alpha_Taiwan_RD901F-20-20R.step
SA_3dshapes/Alpha_Taiwan_RV16AF-20/Alpha_Taiwan_RV16AF-20-BrownOriginal.step
SA_3dshapes/Alpha_Taiwan_RV16AF-20/Alpha_Taiwan_RV16AF-20.step
SA_3dshapes/Alpha_Taiwan_RV16AF-41/rv16-step.stp
SA_3dshapes/C&K_7101SYZBE/C&K_7203SCWZQE.step
SA_3dshapes/C&K_7101SYZBE/C&K_GT21MCBE.step
SA_3dshapes/Hammond_1590A/1590A.igs
SA_3dshapes/Hammond_1590A/1590A.stp
SA_3dshapes/Hammond_1590B/1590B.dwg
SA_3dshapes/Hammond_1590B/1590B.igs
SA_3dshapes/Hammond_1590B/1590B.stp
SA_3dshapes/Hammond_1590BB/1590BB.dwg
SA_3dshapes/Hardware/Hex Spacers/Hex Spacer FF M3 L10mm.stp
SA_3dshapes/Hardware/Hex Spacers/Hex Spacer FF M3 L11mm.stp
SA_3dshapes/Hardware/Hex Spacers/Hex Spacer FF M3 L12mm.stp
SA_3dshapes/Hardware/Hex Spacers/Hex Spacer FF M3 L13mm.stp
SA_3dshapes/Hardware/Hex Spacers/Hex Spacer FF M3 L14mm.stp
SA_3dshapes/Hardware/Hex Spacers/Hex Spacer FF M3 L15mm.stp
SA_3dshapes/Hardware/Hex Spacers/Hex Spacer FF M3 L17mm.stp
SA_3dshapes/Hardware/Hex Spacers/Hex Spacer FF M3 L18mm.stp
SA_3dshapes/Hardware/Hex Spacers/Hex Spacer FF M3 L19mm.stp
SA_3dshapes/Hardware/Hex Spacers/Hex Spacer FF M3 L20mm.stp
SA_3dshapes/Hardware/Hex Spacers/Hex Spacer FF M3 L25mm.stp
SA_3dshapes/Hardware/Hex Spacers/Hex Spacer FF M3 L30mm.stp
SA_3dshapes/Hardware/Hex Spacers/Hex Spacer FF M3 L35mm.stp
SA_3dshapes/Hardware/Hex Spacers/Hex Spacer FF M3 L40mm.stp
SA_3dshapes/Hardware/Hex Spacers/Hex Spacer FF M3 L45mm.stp
SA_3dshapes/Hardware/Hex Spacers/Hex Spacer FF M3 L50mm.stp
SA_3dshapes/Hardware/Hex Spacers/Hex Spacer FF M3 L55mm.stp
SA_3dshapes/Hardware/Hex Spacers/Hex Spacer FF M3 L5mm.stp
SA_3dshapes/Hardware/Hex Spacers/Hex Spacer FF M3 L60mm.stp
SA_3dshapes/Hardware/Hex Spacers/Hex Spacer FF M3 L6mm.stp
SA_3dshapes/Hardware/Hex Spacers/Hex Spacer FF M3 L7mm.stp
SA_3dshapes/Hardware/Hex Spacers/Hex Spacer FF M3 L8mm.stp
SA_3dshapes/Hardware/Hex Spacers/Hex Spacer FF M3 L9mm.stp
SA_3dshapes/Hardware/Hex Spacers/Hex Spacer MF M3 L10mm.stp
SA_3dshapes/Hardware/Hex Spacers/Hex Spacer MF M3 L11mm.stp
SA_3dshapes/Hardware/Hex Spacers/Hex Spacer MF M3 L12mm.stp
SA_3dshapes/Hardware/Hex Spacers/Hex Spacer MF M3 L13mm.stp
SA_3dshapes/Hardware/Hex Spacers/Hex Spacer MF M3 L14mm.stp
SA_3dshapes/Hardware/Hex Spacers/Hex Spacer MF M3 L15mm.stp
SA_3dshapes/Hardware/Hex Spacers/Hex Spacer MF M3 L16mm.stp
SA_3dshapes/Hardware/Hex Spacers/Hex Spacer MF M3 L18mm.stp
SA_3dshapes/Hardware/Hex Spacers/Hex Spacer MF M3 L19mm.stp
SA_3dshapes/Hardware/Hex Spacers/Hex Spacer MF M3 L20mm.stp
SA_3dshapes/Hardware/Hex Spacers/Hex Spacer MF M3 L25mm.stp
SA_3dshapes/Hardware/Hex Spacers/Hex Spacer MF M3 L30mm.stp
SA_3dshapes/Hardware/Hex Spacers/Hex Spacer MF M3 L35mm.stp
SA_3dshapes/Hardware/Hex Spacers/Hex Spacer MF M3 L40mm.stp
SA_3dshapes/Hardware/Hex Spacers/Hex Spacer MF M3 L45mm.stp
SA_3dshapes/Hardware/Hex Spacers/Hex Spacer MF M3 L4mm.step
SA_3dshapes/Hardware/Hex Spacers/Hex Spacer MF M3 L4mm_Brass.step
SA_3dshapes/Hardware/Hex Spacers/Hex Spacer MF M3 L50mm.stp
SA_3dshapes/Hardware/Hex Spacers/Hex Spacer MF M3 L55mm.stp
SA_3dshapes/Hardware/Hex Spacers/Hex Spacer MF M3 L5mm.stp
SA_3dshapes/Hardware/Hex Spacers/Hex Spacer MF M3 L60mm.stp
SA_3dshapes/Hardware/Hex Spacers/Hex Spacer MF M3 L6mm.stp
SA_3dshapes/Hardware/Hex Spacers/Hex Spacer MF M3 L7mm.stp
SA_3dshapes/Hardware/Hex Spacers/Hex Spacer MF M3 L8mm.stp
SA_3dshapes/Hardware/Hex Spacers/Hex Spacer MF M3 L9mm.stp
SA_3dshapes/Hardware/Nuts/Nut_M3.STEP
SA_3dshapes/Hardware/Screws/Screw_Panhead_M3x6.step
SA_3dshapes/Hardware/Screws/Screw_Panhead_M3x8.STEP
SA_3dshapes/Knobs/Knob_Round_Knurled_Indicator_Line_19.1 mm_Round_6.35 mm.stp
SA_3dshapes/Knobs/vol control/12.8 旋钮.SLDASM
SA_3dshapes/Knobs/vol control/12.8 旋钮.SLDPRT
SA_3dshapes/Knobs/vol control/12.8 旋钮.STEP
SA_3dshapes/Knobs/vol control/宽 20 inner.SLDPRT
SA_3dshapes/Lumberg_1614_09/Lumberg_1614_09_Bottom.step
SA_3dshapes/Lumberg_KLBM_3/Lumberg_KLBM_3_z0_r0.step
SA_3dshapes/Lumberg_KLBM_3/Lumberg_KLBM_3_z0_r180.step
SA_3dshapes/Lumberg_KLBM_3/Lumberg_KLBM_3_z0_r270.step
SA_3dshapes/Lumberg_KLBM_3/Lumberg_KLBM_3_z0_r90.step
SA_3dshapes/Lumberg_KLBM_3/Lumberg_KLBM_3_z10_r0.step
SA_3dshapes/Lumberg_KLBM_3/Lumberg_KLBM_3_z10_r180.step
SA_3dshapes/Lumberg_KLBM_3/Lumberg_KLBM_3_z10_r270.step
SA_3dshapes/Lumberg_KLBM_3/Lumberg_KLBM_3_z10_r90.step
SA_3dshapes/Lumberg_KLBM_3/Lumberg_KLBM_3_z12.5_r0.step
SA_3dshapes/Lumberg_KLBM_3/Lumberg_KLBM_3_z12.5_r180.step
SA_3dshapes/Lumberg_KLBM_3/Lumberg_KLBM_3_z12.5_r90.step
SA_3dshapes/Lumberg_KLBM_3/Lumberg_KLBM_3_z8.5_r0.step
SA_3dshapes/Lumberg_KLBM_3/Lumberg_KLBM_3_z8.5_r180.step
SA_3dshapes/Lumberg_KLBM_3/Lumberg_KLBM_3_z8.5_r270.step
SA_3dshapes/Lumberg_KLBM_3/Lumberg_KLBM_3_z8.5_r90.step
SA_3dshapes/Lumberg_KLBM_3/archive/Lumberg_KLBM_3_L_z0_r0.step
SA_3dshapes/Lumberg_KLBM_3/archive/Lumberg_KLBM_3_L_z0_r180.step
SA_3dshapes/Lumberg_KLBM_3/archive/Lumberg_KLBM_3_L_z0_r270.step
SA_3dshapes/Lumberg_KLBM_3/archive/Lumberg_KLBM_3_L_z0_r90.step
SA_3dshapes/Lumberg_KLBM_3/archive/lumberg_klbm_3.stp
SA_3dshapes/Lumberg_NEB_J_21_C/Lumberg_NEB_J_21_C_Bottom.step
SA_3dshapes/Lumberg_NEB_J_21_C/Lumberg_NEB_J_21_C_Top.step
SA_3dshapes/Neutrik_NMJ6HCD2/Neutrik_NMJ6HCD2.step
SA_3dshapes/Neutrik_NMJ6HCD2/User Library-Audio Jack Neutrik Amphenol 6_35.STEP
SA_3dshapes/Neutrik_NMJ6HCD2/User Library-NMJ6HCD2.STEP
SA_3dshapes/Packages/C_0603_1608Metric.step
SA_3dshapes/Packages/C_0805_2012Metric.step
SA_3dshapes/Packages/C_1206_3216Metric.step
SA_3dshapes/Packages/Capacitor_Electrolytic_10x16x5.0mm.step
SA_3dshapes/Packages/Capacitor_Electrolytic_10x16x5.0mm_RA.step
SA_3dshapes/Packages/Capacitor_Electrolytic_5x11x2mm.step
SA_3dshapes/Packages/Capacitor_Electrolytic_5x11x2mm_RA.step
SA_3dshapes/Packages/Capacitor_Electrolytic_6.3x11x2.5mm.step
SA_3dshapes/Packages/Capacitor_Electrolytic_6.3x11x2.5mm_RA.step
SA_3dshapes/Packages/Capacitor_Electrolytic_8x11.5x3.5mm.step
SA_3dshapes/Packages/Capacitor_Electrolytic_8x11.5x3.5mm_RA.step
SA_3dshapes/Packages/DIP_6_Socket.step
SA_3dshapes/Packages/DIP_8_Socket.step
SA_3dshapes/Packages/DIP_8_Socket_With_Kemet_EA2-5SNJ.step
SA_3dshapes/Packages/D_DO-35_SOD27_P10.16mm_Horizontal.step
SA_3dshapes/Packages/D_DO-35_SOD27_P2.54mm_Vertical_AnodeUp.step
SA_3dshapes/Packages/D_DO-35_SOD27_P2.54mm_Vertical_AnodeUp_Grey.step
SA_3dshapes/Packages/D_DO-35_SOD27_P2.54mm_Vertical_KathodeUp.step
SA_3dshapes/Packages/D_DO-35_SOD27_P7.62mm_Horizontal.step
SA_3dshapes/Packages/D_DO-41_SOD81_P10.16mm_Horizontal.step
SA_3dshapes/Packages/D_DO-41_SOD81_P2.54mm_Vertical_AnodeUp.step
SA_3dshapes/Packages/D_DO-41_SOD81_P2.54mm_Vertical_KathodeUp.step
SA_3dshapes/Packages/D_DO-41_SOD81_P7.62mm_Horizontal.step
SA_3dshapes/Packages/Jack_Open.STEP
SA_3dshapes/Packages/LDR_In_THT_01x02_Female_Header.step
SA_3dshapes/Packages/LED_5mm_Yellow.step
SA_3dshapes/Packages/LED_5mm_Yellow_Cut_H5.0mm.step
SA_3dshapes/Packages/PinHeader_1x02_P2.54mm_Horizontal_Bottom.step
SA_3dshapes/Packages/PinHeader_1x02_P2.54mm_Vertical_Top.step
SA_3dshapes/Packages/PinHeader_1x02_P254mm_Vertical_Bottom.step
SA_3dshapes/Packages/PinHeader_1x03_P2.54mm_Vertical_Top.step
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
