julessouren/kicad-library-sa/(commit log)

2018-12-26 Harmonized footprints
    [ON_Semi_MCH6341-TL-W_SOT-363_SC-70-6_SC-88.step, ON_Semi_NL37WZ14USG_US8-8.step, ON_Semi_US8-8.step, Texas_Instruments_SM8_DCT_SSOP-8.step, Texas_Instruments_SN74LVC3G14DCTR_SM8_DCT_SSOP-8.step]
2018-12-27 Added diodes, voltage regulator
    [ON_Semi_1N4148WS_SOD-323F-2.step, ON_Semi_1SMA5918BT3G_SMA_DO-214AC.step, ON_Semi_1SMA5924BT3G_SMA_DO-214AC.step, ON_Semi_1SMA5931BT3G_SMA_DO-214AC.step, ON_Semi_NCP1117LPST50T3G_SOT-223-3.step, Rectron_FM4007W-W_SMA_DO-214AC.step, Rectron_FM5817W_SMA_DO-214AC.step, Rectron_FM5819W_SMA_DO-214AC.step]
2018-12-28 Added tons of symbols, footprints, models
    [ASSEMBLY_cp.step, EA2-5TNU.stl, EA2-5TNU.stp, Fusion.step, Fusion2.step, Kemet_EA2-5NJ.stp, Kemet_EA2-5NJ_Line.step, Nichicon_UWT1E101MCL1GS_100uF_25V_6.3x7.7mm.step]
2018-12-28 Even more additions...
    [Atmel_ATtiny13A-PU.step, Atmel_ATtiny13A-PU_Socketed.step, Atmel_ATtiny85-20PU.step, Atmel_ATtiny85-20PU_Socketed.step, DIP-4_.step, DIP-4_Socketed.step, DIP-8.step, DIP-8_Socketed.step]
2018-12-29 Added Wima FKP caps, stadardized schematic text properties
    [Wima_FKP2J001001D00JSSD.step, Wima_FKP2J001501D00JSSD.step, Wima_FKP2J002201D00JSSD.step, Wima_FKP2J003301D00JSSD.step, Wima_FKP2J004701D00JSSD.step, Wima_FKP2J006801D00JSSD.step]
2018-12-31 Added Wima caps, electrolytics, JFETs
    [Capacitor_Electrolytic_10x16x5.0mm.step, Capacitor_Electrolytic_10x16x5.0mm_RA.step, Capacitor_Electrolytic_5x11x2mm.step, Capacitor_Electrolytic_5x11x2mm_RA.step, Capacitor_Electrolytic_6.3x11x2.5mm.step, Capacitor_Electrolytic_6.3x11x2.5mm_RA.step, Capacitor_Electrolytic_8x11.5x3.5mm.step, Capacitor_Electrolytic_8x11.5x3.5mm_RA.step]
2018-12-31 Added many new packages
    [ALPHA-RD901F-40.step, Bourns_3296W-1-104.step, Bourns_3314G-1-104E.step, Bourns_3362P-1-104.step, Bourns_TC33X-2-104E.step, C_0603_1608Metric.step, C_0805_2012Metric.step, C_1206_3216Metric.step]
2019-01-01 Added Alpha 9mm pots
    [ALPS-RK097.step, Alpha_Taiwan_9mm_Horizontal.step, Alpha_Taiwan_9mm_Vertical.step]
2019-01-04 Added pots, jacks, pin headers
    [1590A.igs, 1590A.stp, 1590B.dwg, 1590B.igs, 1590B.stp, ALPHA-RD901F-40.step, ALPS-RK097.step, ALPS-RK09712.step]
2019-02-05 Added lots of modules and components
    [Lumberg_1614_09_Bottom.step, Lumberg_1614_09_Bottom_Combined.step, Lumberg_1614_09_Top.step, Lumberg_NEB_J_21_C.stp, Lumberg_NEB_J_21_C_Bottom.step, Lumberg_NEB_J_21_C_Top.step, PinHeader_1x02_P2.54mm_Vertical_Top.step, PinHeader_1x02_P254mm_Vertical_Bottom.step]
2019-02-05 Added 40106 SOIC-14 and TSSOP-14 footprints, ROHM SSOP-8 single inverter
    [ROHM_Semi_BU4S584G2-TR_SSOP-5.stp, Texas_Instruments_CD40106BM_SOIC-14.step, Texas_Instruments_CD40106BPWR_TSSOP-14.step]
2019-02-05 Added 1x7 pin header for DIP-14 breakout
2019-02-07 Added relay 3d models, momentary switch 3d model
    [ASSEMBLY_cp.step, EA2-5TNU.stl, EA2-5TNU.stp, Fusion.step, Fusion2.step, Kemet_EA2-5NJ.step, Kemet_EA2-5NJ.stp, Kemet_EA2-5NJ_Line.step]
2019-02-08 Added Hammond enclosures
    [1590A_NoLid.step, 1590BB.dwg, 1590BB.stp, 1590BB_NoLid.step, 1590B_NoLid_Alpha_9mm_Vert.step, Knob_Round_Knurled_Indicator_Line_19.1 mm_Round_6.35 mm.stp, PinHeader_1x02_P2.54mm_Horizontal_Bottom.step]
2019-02-25 Many parts added...
    [ALPHA-RD901F-40.step, ALPS-RK097.step, ALPS-RK09712.step, ALPS-RK09712_Horizontal_Dual.step, ALPS-RK097_Horizontal.step, ALPS-RK09K.step, Alpha_9mm_Vertical_RD901F-40.step, Alps_RK09K_Vertical_Plastic_Trimmer.step]
2019-02-26 Added SMD pin headers, pots
    [Alpha_16mm_Horizontal_T18.step, Alpha_16mm_Solder_Lugs_Single_Pot.IGS, Alpha_16mm_Solder_Lugs_Stereo_Pot.IGS, Alpha_16mm_Solder_Lugs_Switch_Pot_Small_Shaft.IGS, Alpha_24mm_Solder_Lugs.step, Preci-dip_310-87-103-41-105101.step, Preci-dip_310-87-104-41-105101.step, Preci-dip_310-87-105-41-105101.step]
2019-03-04 Added more pots and switches
    [Alpha_Taiwain_RD902F-20.step, Alpha_Taiwan_RD901F-20.step, Alpha_Taiwan_RD901F-40.step, Alpha_Taiwan_RD902F-40.step, Alpha_Taiwan_RV16A01F-20-BrownOriginal.step, Alpha_Taiwan_RV16A01F-20.step, Alpha_Taiwan_RV16AF-10.step, Alpha_Taiwan_RV16AF-10_FC.step]
2019-03-04 added plastic 9mm pot
    [Alpha_Taiwan_RV09AF-40.step, User Library-RV09ACF-40_RK09K1130A5R.STEP]
2019-03-04 Updated pot footprints
    [Alpha_Taiwan_RV16AF-10_FC.step, PDB182-GTR.stp, Stereo_Pot.IGS, Stereo_Pot_Direct_Export.step, verical_t18.stl]
2019-03-04 Added Neutrik NMJ6HCD2
    [InputJack_Cover_Assembly.stp, Neutrik_NMJ6HCD2.step, User Library-Audio Jack Neutrik Amphenol 6_35.STEP, User Library-NMJ6HCD2.STEP]
2019-04-16 hex spacer 3d models
    [12.8 INNER.SLDPRT, 12.8 旋钮.SLDASM, 12.8 旋钮.SLDPRT, 12.8 旋钮.STEP, Assem1.SLDASM, CLP_103_02_F_D.step, Hex Spacer FF M3 L10mm.stp, Hex Spacer FF M3 L11mm.stp]
2019-06-19 Added STEP models and datasheets
    [11002_sp.step, 11002_sp_Colored.step, Amphenol_ACJS-MHOM.step, Belton_BTDR-2H.step, Lumberg_KLBM_3.step, Lumberg_NEB_J_21_C.step, Neutrik_NMJ6HCD2_NoNose.step, Neutrik_NMJ6HCD2_OnlyNose.step]
2019-06-25 Added datasheets various switches
2019-07-16 Added datasheets
    [ON_Semi_2N3904TAR-TO-92-3-P2.54_Marking.step, Texas_Instruments_CD40106BPWR_TSSOP-14_Markings.step]
