julessouren/kicad-library-sa/(notices)

Notices in the files:
SA_3dshapes/Nichicon_UWT1V220MCL1GB_22uF_35V_6.3x5.4mm/Nichicon_UWT1V220MCL1GB_22uF_35V_6.3x5.4mm.step:
Copyright (C) 2018, kicad StepUp
This work is licensed under the [Creative Commons CC-BY-SA 4.0 License](https://creativecommons.org/licenses/by-sa/4.0/legalcode),
with the following exception:
To the extent that the creation of electronic designs that use 'Licensed Material' can be considered to be 'Adapted Material',
You are free to use the library data in your own projects without the obligation to share your project files under this or any other license agreement.
SA_3dshapes/Texas_Instruments_CD40106BM_SOIC-14/Texas_Instruments_CD40106BM_SOIC-14.step:
Copyright (C) 2017, kicad StepUp
SA_3dshapes/Rectron_FM5819W_SMA_DO-214AC/Rectron_FM5819W_SMA_DO-214AC.step:
This program is free software: you can redistribute it and/or modify
it under the terms of the GNU General Public License as published by
the Free Software Foundation, either version 3 of the License, or
any later version.
itself might be covered by the GNU General Public License.
